brickrockler/surfclock/FINAL_PRINT_FILES/PURE_BLENDER_CYCLES_LOOKBOOK/08_colorway_02_panda_monochrome.jpg

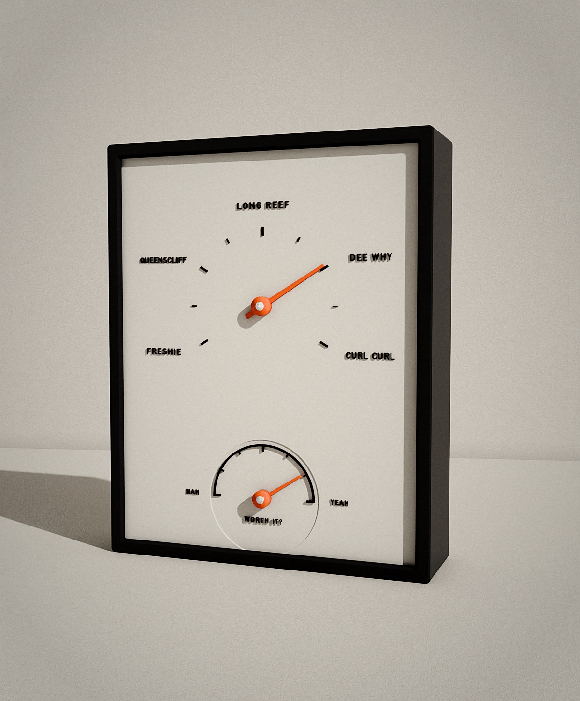
FINAL_PRINT_FILES/PURE_BLENDER_CYCLES_LOOKBOOK/08_colorway_02_panda_monochrome.jpg
