brickrockler/surfclock/HANDOFF.md

# Surf Clock Project Context (Auto-Loaded by Local Antigravity / Jetski IDE)

You are picking up the active industrial design, 3D printing, CAD, and firmware engineering session for `jcolley`'s **Surf Clock (001 Dieter Rams / Braun / Teenage Engineering V5 Click-Lock Edition)** in `/Users/jcolley/surf_clock`.

Read `README_ANTIGRAVITY_HANDOFF.md`, `V5_PERFECT_CLICKLOCK_PRINT_KIT/README_EXACT_PRINT_SETTINGS.md`, and `HANDOFF.md` immediately before responding to the user.

## Critical Execution Rules (Always On)
1. **Never Trigger IDE "Accept/Reject File" Banners**: Never use `write_to_file` or `replace_file_content`. Always create and modify files directly via `run_command` (`python3`, `cat << 'EOF'`, Blender CLI).
2. **Zero Confirmation Questions**: Execute all CAD, slicer, firmware, and script updates autonomously end-to-end.

## Current State & V5 Click-Lock Print Kit (`/Users/jcolley/surf_clock/V5_PERFECT_CLICKLOCK_PRINT_KIT/`)
All V5 STL files are 100% watertight (`non_manifold = 0`) and synced to `/Users/jcolley/surf_clock/FINAL_PRINT_FILES/`:
1. **`1_Outer_Frame_ClickLock_PrusaMK4.stl`** (`230.0 × 184.0 × 52.0 mm`, `166.9 cm³`) — Already printed by user with Fuzzy Skin (`0.10 / 0.30 mm`). Clean bezel corners (no circular corner nubs) + self-supporting `28°–31°` click-lock ledges (`0` overhang warnings). Optional slim version: `1b_OPTIONAL_Outer_Frame_SLIM_36mm_FastPrint_PrusaMK4.stl` (`36.0 mm` deep).
2. **`2a_Dial_Face_NORTHERN_BEACHES_Queensie_M600_at_Z2.6mm_PrusaMK4.stl`**, **`2b_Dial_Face_SYDNEY_ICONS_Bondi_Bronte_M600_at_Z2.6mm_PrusaMK4.stl`**, **`2c_Dial_Face_EASTERN_SUBURBS_Bondi_Coogee_M600_at_Z2.6mm_PrusaMK4.stl`** (`221.5 × 175.5 × 3.20 mm`) — Pure sharp rectangular dial plates (ZERO corner notches, ZERO boolean corner box artifacts, ZERO duplicate-triangle vulnerabilities). Slice at `0.20mm` with `M600` filament swap from Matte White to Matte Black at **`Z = 2.60 mm` (Layer 14)**.
3. **`NEW3_Motor_Mount_Plate_ClickLock_Audited_PrusaMK4.stl`** (also `FINAL_PRINT_FILES/3_Motor_Mount_Plate_ORANGE_or_WHITE_PrusaMK4.stl`, `222.4 × 176.4 × 12.6 mm`) — Features the sleek low-profile V3 ESP32 cradle (`Z = 9.50 mm` PCB shelf, `Z = 11.20 mm` side walls, `45°` snap clips) shifted UP `+41.0 mm` (`X = +2.0..+59.5 mm, Y = -51.0 mm`) for `51.8 mm` of USB-C plug clearance; and **Layers 1–3 (`Z = 0.00–0.60 mm`) are a 100% continuous unbroken flat sheet** (`38,491 mm²` bed contact area; all pin pockets and perimeter flex slots start at `Z = 0.60 mm` / Layer 4).
4. **`4a_Back_Cover_PURE_FLAT_TRANSLUCENT_HiddenClips_PrusaMK4.stl`**, **`4b_Back_Cover_BRAUN_LOUVERED_HiddenClips_PrusaMK4.stl`**, and **`4c_Back_Cover_FAST_1HR_CLEAR_WINDOW_PrusaMK4.stl`** (`222.0 × 176.0 × 7.5 mm`) — `4c` features a `3.0 mm` structural perimeter rim with a `1.0 mm` (4-layer) recessed optical center window that prints in `~55 minutes` with 3× clearer transparency.
5. **`5_Pointer_Hands_Skinny_Capped_PrusaMINI.stl`** — Skinny extended Braun pointer hands with built-in `Ø6.80 mm` shaft extender stems, `28BYJ-48` keyed D-bores, and solid capped tops.
6. **All CAD Generator Scripts:** Permanently saved in `/Users/jcolley/surf_clock/V5_PERFECT_CLICKLOCK_PRINT_KIT/scripts/`.
