brickrockler/surfclock/README_ANTIGRAVITY_HANDOFF.md

# 🚀 START HERE: Recreate Our Complete Conversation in Antigravity

Open `/Users/jcolley/surf_clock` as your workspace in **Antigravity**, then **copy and paste the prompt block below** into a new chat window. It points Antigravity to every STL, CAD script, print setting, firmware file, web app file, and design decision from our session.

---

## 📋 COPY & PASTE THIS PROMPT INTO ANTIGRAVITY

```text
You are picking up the active industrial design, 3D printing, CAD, and firmware engineering session for jcolley's Surf Clock (001 Dieter Rams / Braun / Teenage Engineering V5 Click-Lock Edition) in `/Users/jcolley/surf_clock`.

Before responding, read:
1. `/Users/jcolley/surf_clock/README_ANTIGRAVITY_HANDOFF.md`
2. `/Users/jcolley/surf_clock/V5_PERFECT_CLICKLOCK_PRINT_KIT/README_EXACT_PRINT_SETTINGS.md`
3. `/Users/jcolley/surf_clock/AGENTS.md`

CRITICAL EXECUTION RULES:
- Never use `write_to_file` or `replace_file_content` (which trigger IDE Accept/Reject diff banners). Always create/modify files directly on disk using `run_command` (`python3`, `cat << 'EOF'`, Blender CLI).
- Execute all tasks end-to-end autonomously without asking technical confirmation questions.

Here is the complete map of our workspace and current status:

1. FINAL V5 CLICK-LOCK 3D PRINT KIT (`/Users/jcolley/surf_clock/V5_PERFECT_CLICKLOCK_PRINT_KIT/` & synced in `/Users/jcolley/surf_clock/FINAL_PRINT_FILES/`):
   All STLs are 100% watertight (`non_manifold = 0`) and engineered for screwless click-lock assembly on 2x Prusa MK4 + 1x Prusa MINI:
   - `1_Outer_Frame_ClickLock_PrusaMK4.stl` (230.0 x 184.0 x 52.0 mm, 166.9 cm³): Already printed by user in Matte PLA with Fuzzy Skin (`0.10 mm` thickness / `0.30 mm` point distance). Features clean bezel corners (no circular corner nubs), 28°–31° self-supporting internal click-lock ramps (`0` overhang warnings), and rear snap-clip undercuts. (For future prints, use `Seam position: Random` or paint seam on bottom desk-facing edge to hide the Z-seam on fuzzy skin).
   - `1b_OPTIONAL_Outer_Frame_SLIM_36mm_FastPrint_PrusaMK4.stl` (230.0 x 184.0 x 36.0 mm, 118.9 cm³): Optional slimmer 36 mm depth frame (-30% print time).
   - `2a_Dial_Face_NORTHERN_BEACHES_Queensie_M600_at_Z2.6mm_PrusaMK4.stl`, `2b_Dial_Face_SYDNEY_ICONS_Bondi_Bronte_M600_at_Z2.6mm_PrusaMK4.stl`, `2c_Dial_Face_EASTERN_SUBURBS_Bondi_Coogee_M600_at_Z2.6mm_PrusaMK4.stl`: Pure 221.5 x 175.5 x 2.40 mm sharp rectangular dial plates (ZERO corner notches, ZERO boolean corner box artifacts, ZERO duplicate triangles / PrusaSlicer vulnerabilities) with +0.20 mm white flare pedestal (`Z = 2.40–2.60 mm`) and +0.60 mm raised DIN/Braun lettering (`Z = 2.60–3.20 mm`). Slice at `0.20mm` with `M600` color change from White to Black at `Z = 2.60 mm` (Layer 14).
   - `NEW3_Motor_Mount_Plate_ClickLock_Audited_PrusaMK4.stl` (also synced to `FINAL_PRINT_FILES/3_Motor_Mount_Plate_ORANGE_or_WHITE_PrusaMK4.stl` & `3_Motor_Mount_Plate_V3_SCREWLESS_PrusaMK4.stl`, 222.4 x 176.4 x 12.6 mm):
     * Uses the sleek low-profile V3 ESP32 cradle (`Z = 9.50 mm` PCB shelf, `Z = 11.20 mm` side walls, 45° snap clips) shifted UP +41.0 mm (`X = +2.0..+59.5 mm, Y = -51.0 mm`) for 51.8 mm of straight USB-C cable clearance inside the frame.
     * Layers 1–3 (`Z = 0.00 to 0.60 mm`) are a 100% continuous unbroken flat sheet (`38,491 mm²` bed contact area; only the two Ø10.4 mm round shaft holes pass through Layer 1). All board pin pockets, windows, and the 10 perimeter flex slots start at `Z = 0.60 mm` (Layer 4) so Layer 1 never snags or peels.
   - `4a_Back_Cover_PURE_FLAT_TRANSLUCENT_HiddenClips_PrusaMK4.stl` (222.0 x 176.0 x 3.0 mm flat translucent sheet with 10 hidden inner snap hooks), `4b_Back_Cover_BRAUN_LOUVERED_HiddenClips_PrusaMK4.stl` (louvered exhibition back), and `4c_Back_Cover_FAST_1HR_CLEAR_WINDOW_PrusaMK4.stl` (3.0 mm structural perimeter rim + 1.0 mm / 4-layer recessed optical window in the center that prints in ~55 mins with 3x better transparency).
   - `5_Pointer_Hands_Skinny_Capped_PrusaMINI.stl` (and `FINAL_PRINT_FILES/5_AND_6_COMBINED_Hands_Plus_Snap_Pins_PrusaMINI.stl`): Skinny Braun pointer hands with built-in Ø6.80 mm shaft extender stems, 28BYJ-48 keyed D-bores, and solid capped tops.

2. ALL CAD GENERATOR SCRIPTS (`/Users/jcolley/surf_clock/V5_PERFECT_CLICKLOCK_PRINT_KIT/scripts/` & root `/Users/jcolley/surf_clock/`):
   - `build_audited_v5_all_parts_low_esp32.py` — Master V5 generator for the low-profile ESP32 cradle & click-lock motor mount plate.
   - `make_first_3_layers_unbroken_sheet.py` & `upgrade_motorplate_only.py` — Makes Layers 1–3 (`Z = 0.00–0.60 mm`) a continuous unbroken flat sheet and adds the 10 perimeter click-lock ramps/slots starting at `Z = 0.60 mm`.
   - `generate_zero_vulnerability_dials.py` & `clean_base_plate.stl` — Generates `2a`, `2b`, `2c` dial faces with micro-offset non-overlapping letter strokes and a pure rectangular base plate (`0` non-manifold edges, `0` duplicate triangles).
   - `build_52mm_and_slim_36mm_frames.py` & `fix_all_overhangs_frame.py` — Generates `1_Outer_Frame_ClickLock_PrusaMK4.stl` (52 mm) and `1b` (36 mm) with clean corners and 28°–31° self-supporting internal ledges.
   - `build_fast_clear_window_back_cover.py` & `build_seamless_hidden_clip_back_and_frame.py` — Generates `4a`, `4b`, and `4c` snap-fit rear covers.

3. 30 INDUSTRIAL DESIGN EXPLORATIONS (`/Users/jcolley/surf_clock/DESIGN_EXPLORATION_30_PRINTABLE_IMAGES/`):
   - Generated by `/Users/jcolley/surf_clock/generate_30_printable_design_exploration_images.py`.
   - Contains 30 distinct 3D-printable industrial design variations (`INDIVIDUAL_CARDS_WITH_LABELS/`, `INDIVIDUAL_CARDS_NO_TEXT/`), 5 presentation boards (`Board_1...Board_5`), and `00_MASTER_30_DESIGN_EXPLORATIONS_POSTER.jpg`.

4. BUILD & WIRING VIDEO, WEB CUSTOMIZER & FIRMWARE:
   - Master Build & Wiring Video: `/Users/jcolley/surf_clock/SURF_CLOCK_001_COMPLETE_BUILD_AND_WIRING_GUIDE.mp4` (and `FINAL_PRINT_FILES/0_WATCH_FIRST_BUILD_AND_WIRING_VIDEO.mp4`), built by `render_real_3d_stl_chapters.py` and `build_guide_video_render.py`.
   - Web Customizer App: `/Users/jcolley/surf_clock/web_customizer/` (`index.html`, `app.js`, `studio_3d.js`, `glyphs_3d.js`, `surf_data.js`, `package_generator.js`).
   - ESP32-S3 Firmware: `/Users/jcolley/surf_clock/surf_clock_esp32s3_magnet_free.ino` & `/Users/jcolley/surf_clock/firmware_platformio/` (magnet-free `RTC_DATA_ATTR` + `Preferences` NVS flash persistence).

Confirm you have loaded all context above and are ready to help with printing, assembly, firmware, or design!
```

---

## 📂 Complete Directory & File Index (`/Users/jcolley/surf_clock`)

### 1. Primary V5 Click-Lock Print Kit (`V5_PERFECT_CLICKLOCK_PRINT_KIT/`)
| File | Dimensions | Print Time & Slicer Summary |
| :--- | :--- | :--- |
| [`1_Outer_Frame_ClickLock_PrusaMK4.stl`](file:///Users/jcolley/surf_clock/V5_PERFECT_CLICKLOCK_PRINT_KIT/1_Outer_Frame_ClickLock_PrusaMK4.stl) | `230.0 × 184.0 × 52.0 mm` | **Already Printed!** Face-down (`Z=0`), `0.20mm STRUCTURAL` or `SPEED`, no supports, optional Fuzzy Skin (`0.10mm / 0.30mm`, `Seam: Random`). |
| [`1b_OPTIONAL_Outer_Frame_SLIM_36mm_FastPrint_PrusaMK4.stl`](file:///Users/jcolley/surf_clock/V5_PERFECT_CLICKLOCK_PRINT_KIT/1b_OPTIONAL_Outer_Frame_SLIM_36mm_FastPrint_PrusaMK4.stl) | `230.0 × 184.0 × 36.0 mm` | Optional slim 36 mm frame (`-30%` print time). |
| [`2a_Dial_Face_NORTHERN_BEACHES_Queensie_M600_at_Z2.6mm_PrusaMK4.stl`](file:///Users/jcolley/surf_clock/V5_PERFECT_CLICKLOCK_PRINT_KIT/2a_Dial_Face_NORTHERN_BEACHES_Queensie_M600_at_Z2.6mm_PrusaMK4.stl) | `221.5 × 175.5 × 3.20 mm` | ~`1h 15m` (`0.20mm SPEED` or `STRUCTURAL`, 15% Grid infill). Add `M600` filament swap from White to Black at **`Z = 2.60 mm` (Layer 14)**. Zero corner notches, zero slicer warnings. |
| [`2b_Dial_Face_SYDNEY_ICONS_Bondi_Bronte_M600_at_Z2.6mm_PrusaMK4.stl`](file:///Users/jcolley/surf_clock/V5_PERFECT_CLICKLOCK_PRINT_KIT/2b_Dial_Face_SYDNEY_ICONS_Bondi_Bronte_M600_at_Z2.6mm_PrusaMK4.stl) | `221.5 × 175.5 × 3.20 mm` | Sydney Icons edition (`PALM BEACH`, `MANLY`, `BONDI`, `CRONULLA`, `BRONTE`). Same `M600` swap at `Z = 2.60 mm`. |
| [`2c_Dial_Face_EASTERN_SUBURBS_Bondi_Coogee_M600_at_Z2.6mm_PrusaMK4.stl`](file:///Users/jcolley/surf_clock/V5_PERFECT_CLICKLOCK_PRINT_KIT/2c_Dial_Face_EASTERN_SUBURBS_Bondi_Coogee_M600_at_Z2.6mm_PrusaMK4.stl) | `221.5 × 175.5 × 3.20 mm` | Eastern Suburbs edition (`BONDI`, `TAMARAMA`, `BRONTE`, `MAROUBRA`, `COOGEE`). Same `M600` swap at `Z = 2.60 mm`. |
| [`NEW3_Motor_Mount_Plate_ClickLock_Audited_PrusaMK4.stl`](file:///Users/jcolley/surf_clock/V5_PERFECT_CLICKLOCK_PRINT_KIT/NEW3_Motor_Mount_Plate_ClickLock_Audited_PrusaMK4.stl) | `222.4 × 176.4 × 12.6 mm` | ~`1h 15m` (`0.20mm SPEED`, `Generic PLA`, `3` perimeters, `First layer height: 0.25 mm`, `First layer speed: 25 mm/s`, `Bed: 65 °C` first layer). Unbroken flat sheet on Layers 1–3 (`Z = 0.00–0.60 mm`) + low-profile V3 ESP32 cradle. |
| [`4a_Back_Cover_PURE_FLAT_TRANSLUCENT_HiddenClips_PrusaMK4.stl`](file:///Users/jcolley/surf_clock/V5_PERFECT_CLICKLOCK_PRINT_KIT/4a_Back_Cover_PURE_FLAT_TRANSLUCENT_HiddenClips_PrusaMK4.stl) | `222.0 × 176.0 × 7.5 mm` | ~`1h 30m` (`0.20mm STRUCTURAL`, `Generic PETG`, `Aligned Rectilinear` 100% infill at `0°` fill angle, **leave default speeds alone—never set infill speed to 25 mm/s**). |
| [`4b_Back_Cover_BRAUN_LOUVERED_HiddenClips_PrusaMK4.stl`](file:///Users/jcolley/surf_clock/V5_PERFECT_CLICKLOCK_PRINT_KIT/4b_Back_Cover_BRAUN_LOUVERED_HiddenClips_PrusaMK4.stl) | `222.0 × 176.0 × 7.5 mm` | Louvered Braun exhibition back cover with hidden snap clips. |
| [`4c_Back_Cover_FAST_1HR_CLEAR_WINDOW_PrusaMK4.stl`](file:///Users/jcolley/surf_clock/V5_PERFECT_CLICKLOCK_PRINT_KIT/4c_Back_Cover_FAST_1HR_CLEAR_WINDOW_PrusaMK4.stl) | `222.0 × 176.0 × 7.5 mm` | **Fastest & Clearest Back Cover (~55 mins):** `3.0 mm` rigid outer rim + `1.0 mm` (4-layer) recessed optical window in the center (`3×` clearer transparency). |
| [`5_Pointer_Hands_Skinny_Capped_PrusaMINI.stl`](file:///Users/jcolley/surf_clock/V5_PERFECT_CLICKLOCK_PRINT_KIT/5_Pointer_Hands_Skinny_Capped_PrusaMINI.stl) | Prusa MINI (`180 × 180 mm`) | ~`28 mins` (`0.15mm STRUCTURAL`, `100%` infill, Ironing ON for topmost surface). |
| [`README_EXACT_PRINT_SETTINGS.md`](file:///Users/jcolley/surf_clock/V5_PERFECT_CLICKLOCK_PRINT_KIT/README_EXACT_PRINT_SETTINGS.md) | — | Step-by-step PrusaSlicer settings for every file above. |

---

### 2. Visual Blueprints & Proof Diagrams (`V5_PERFECT_CLICKLOCK_PRINT_KIT/`)
* [`0_V5_CLICKLOCK_ARCHITECTURE_BLUEPRINT.png`](file:///Users/jcolley/surf_clock/V5_PERFECT_CLICKLOCK_PRINT_KIT/0_V5_CLICKLOCK_ARCHITECTURE_BLUEPRINT.png) — Exploded cross-section of the V5 screwless click-lock assembly stack.
* [`0_HIDDEN_REAR_SNAP_CLIP_DIAGRAM.png`](file:///Users/jcolley/surf_clock/V5_PERFECT_CLICKLOCK_PRINT_KIT/0_HIDDEN_REAR_SNAP_CLIP_DIAGRAM.png) — Detail of the 10 hidden rear snap hooks on the back cover.
* [`0_FIXED_CORNERS_AND_30DEG_RAMPS_PROOF.png`](file:///Users/jcolley/surf_clock/V5_PERFECT_CLICKLOCK_PRINT_KIT/0_FIXED_CORNERS_AND_30DEG_RAMPS_PROOF.png) — Proof of removed corner nubs and self-supporting `28°–31°` overhangs inside the frame.
* [`0_LOW_PROFILE_ESP32_CRADLE_PROOF.png`](file:///Users/jcolley/surf_clock/V5_PERFECT_CLICKLOCK_PRINT_KIT/0_LOW_PROFILE_ESP32_CRADLE_PROOF.png) — Proof of the restored low-profile V3 ESP32 cradle (`Z = 9.50 mm` PCB shelf) shifted up `+41 mm` for `51.8 mm` of USB-C plug clearance.
* [`diagrams_and_renders/motor_plate_unbroken_layer1_proof.png`](file:///Users/jcolley/surf_clock/V5_PERFECT_CLICKLOCK_PRINT_KIT/diagrams_and_renders/motor_plate_unbroken_layer1_proof.png) — Proof that Layers 1–3 (`Z = 0.00–0.60 mm`) of `NEW3_Motor_Mount_Plate` are a continuous unbroken sheet.

---

### 3. CAD Generation & Repair Scripts (`V5_PERFECT_CLICKLOCK_PRINT_KIT/scripts/`)
All Python/Blender scripts created during this session are permanently backed up in [`V5_PERFECT_CLICKLOCK_PRINT_KIT/scripts/`](file:///Users/jcolley/surf_clock/V5_PERFECT_CLICKLOCK_PRINT_KIT/scripts/):
* [`build_audited_v5_all_parts_low_esp32.py`](file:///Users/jcolley/surf_clock/V5_PERFECT_CLICKLOCK_PRINT_KIT/scripts/build_audited_v5_all_parts_low_esp32.py) — Builds the base V5 motor mount plate with the low-profile V3 ESP32 cradle at `Y = -51.0 mm`.
* [`make_first_3_layers_unbroken_sheet.py`](file:///Users/jcolley/surf_clock/V5_PERFECT_CLICKLOCK_PRINT_KIT/scripts/make_first_3_layers_unbroken_sheet.py) — Seals `Z = 0.00–0.60 mm` (Layers 1–3) into an unbroken flat bottom sheet leaving only the two `Ø10.4 mm` shaft holes through Layer 1.
* [`upgrade_motorplate_only.py`](file:///Users/jcolley/surf_clock/V5_PERFECT_CLICKLOCK_PRINT_KIT/scripts/upgrade_motorplate_only.py) — Adds the 10 perimeter click-lock ramps and flex reliefs starting at `Z = 0.60 mm` (Layer 4).
* [`generate_zero_vulnerability_dials.py`](file:///Users/jcolley/surf_clock/V5_PERFECT_CLICKLOCK_PRINT_KIT/scripts/generate_zero_vulnerability_dials.py) & [`clean_base_plate.stl`](file:///Users/jcolley/surf_clock/V5_PERFECT_CLICKLOCK_PRINT_KIT/scripts/clean_base_plate.stl) — Rebuilds `2a`, `2b`, `2c` dial faces with zero corner notches and zero duplicate-triangle slicer warnings.
* [`build_fast_clear_window_back_cover.py`](file:///Users/jcolley/surf_clock/V5_PERFECT_CLICKLOCK_PRINT_KIT/scripts/build_fast_clear_window_back_cover.py) — Builds `4c_Back_Cover_FAST_1HR_CLEAR_WINDOW_PrusaMK4.stl`.
* [`fix_all_overhangs_frame.py`](file:///Users/jcolley/surf_clock/V5_PERFECT_CLICKLOCK_PRINT_KIT/scripts/fix_all_overhangs_frame.py) & [`build_52mm_and_slim_36mm_frames.py`](file:///Users/jcolley/surf_clock/V5_PERFECT_CLICKLOCK_PRINT_KIT/scripts/build_52mm_and_slim_36mm_frames.py) — Builds the 52 mm and 36 mm outer frames with zero overhang warnings.

---

### 4. Key Troubleshooting Notes from Our Session
1. **Why the Translucent Back Cover (`4a`) originally estimated 8 hours:**
   - Setting `Solid infill speed` / `Top solid infill` manually to `25–30 mm/s` overrides Prusa MK4 Input Shaper speeds on a `222 × 176 × 3 mm` solid slab. Leaving speeds at default `0.20mm STRUCTURAL` drops `4a` to `~1h 35m`, and using [`4c_Back_Cover_FAST_1HR_CLEAR_WINDOW_PrusaMK4.stl`](file:///Users/jcolley/surf_clock/V5_PERFECT_CLICKLOCK_PRINT_KIT/4c_Back_Cover_FAST_1HR_CLEAR_WINDOW_PrusaMK4.stl) (`1.0 mm` center optical window) drops print time to **`~55 minutes`** with 3× clearer optics.
2. **Why `2_Dial_Face` had corner notches, a bottom-right vertical box, and slicer vulnerabilities:**
   - Re-running the boolean corner-notch script in-place inverted a cutter box (`Z = -1..+5 mm`), and overlapping 3D letter strokes created duplicate triangles. Fixed permanently via [`generate_zero_vulnerability_dials.py`](file:///Users/jcolley/surf_clock/V5_PERFECT_CLICKLOCK_PRINT_KIT/scripts/generate_zero_vulnerability_dials.py) (`Watertight = True`, `non_manifold = 0`, sharp un-notched corners).
3. **Why `3_Motor_Mount_Plate` wasn't sticking on one Prusa MK4:**
   - In CAD: We sealed Layers 1–3 (`Z = 0.00–0.60 mm`) into a continuous flat sheet so small board cutouts and perimeter flex slots start at Layer 4 (`Z = 0.60 mm`).
   - On the Printer: The Smooth PEI sheet on that MK4 had lost grip (likely from linear rod grease spread by alcohol or PEI glazing), causing melted PLA to lose the tug-of-war with the brass nozzle. **Fix:** Swap the steel sheet from the other MK4, apply glue stick / painter's tape, or scrub the sheet at the sink with hot water + dish soap + the rough green side of a sponge, and print with `Generic PLA` (not Silk PLA) at `First layer speed: 25 mm/s` and `Bed: 65 °C`.
