brickrockler/surfclock/STUDIO_4K_CINEMA_PIPELINE/README_4K_CINEMA_COLLECTION.md

# 001 Surf Clock — V8 Frontier 100-Shot 4K Photography & 4K 60fps Silent Cinema Collection

All **100 Native 4K (`3840×2160`) Studio & Film Stills** and **100 Corresponding 8-Second Silent 4K 60fps (`3840×2160`, `-an`) Cinema Clips** (`V8_001` through `V8_100`) are complete, adversarially audited across 20 overnight iterations, and temporally verified across 5 timepoints (`t=0.0s`, `t=1.5s`, `t=4.2s`, `t=6.2s`, and `t=7.4s`).

## Quick Links
- **Interactive Browser Lookbook (All 100 Stills + 100 Videos Side-by-Side)**: [`00_V8_FRONTIER_100_LOOKBOOK.html`](./00_V8_FRONTIER_100_LOOKBOOK.html)
- **100-Cut Master Selects Reel (Silent 4K 60fps, 3.53 GB)**: [`00_MASTER_SHOWREELS/00_SURF_CLOCK_V8_FRONTIER_MASTER_SELECTS_REEL_4K60_SILENT.mp4`](./00_MASTER_SHOWREELS/00_SURF_CLOCK_V8_FRONTIER_MASTER_SELECTS_REEL_4K60_SILENT.mp4)
- **100 Native 4K Stills (`3840×2160`)**: [`01_4K_STUDIO_KEYFRAMES_AND_STILLS/`](./01_4K_STUDIO_KEYFRAMES_AND_STILLS/)
- **100 Individual Silent 4K 60fps Clips (`8.0s`, `-an`)**: [`02_INDIVIDUAL_4K_CLIPS_16x9/`](./02_INDIVIDUAL_4K_CLIPS_16x9/)

## 5-Point Temporal 10×10 Contact Sheets (`04_CONTACT_SHEETS_AND_AUDIT/`)
- **`t=0.0s` (All 100 4K Stills)**: [`04_CONTACT_SHEETS_AND_AUDIT/00_V8_ALL_100_4K_STILLS_CONTACT_SHEET.jpg`](./04_CONTACT_SHEETS_AND_AUDIT/00_V8_ALL_100_4K_STILLS_CONTACT_SHEET.jpg)
- **`t=1.5s` (All 100 Video Early Frames)**: [`04_CONTACT_SHEETS_AND_AUDIT/00_V8_ALL_100_VIDEO_EARLYFRAMES_t1.5s_CONTACT_SHEET.jpg`](./04_CONTACT_SHEETS_AND_AUDIT/00_V8_ALL_100_VIDEO_EARLYFRAMES_t1.5s_CONTACT_SHEET.jpg)
- **`t=4.2s` (All 100 Video Mid Frames)**: [`04_CONTACT_SHEETS_AND_AUDIT/00_V8_ALL_100_VIDEO_MIDFRAMES_t4.2s_CONTACT_SHEET.jpg`](./04_CONTACT_SHEETS_AND_AUDIT/00_V8_ALL_100_VIDEO_MIDFRAMES_t4.2s_CONTACT_SHEET.jpg)
- **`t=6.2s` (All 100 Video Late Frames)**: [`04_CONTACT_SHEETS_AND_AUDIT/00_V8_ALL_100_VIDEO_LATEFRAMES_t6.2s_CONTACT_SHEET.jpg`](./04_CONTACT_SHEETS_AND_AUDIT/00_V8_ALL_100_VIDEO_LATEFRAMES_t6.2s_CONTACT_SHEET.jpg)
- **`t=7.4s` (All 100 Video End Frames)**: [`04_CONTACT_SHEETS_AND_AUDIT/00_V8_ALL_100_VIDEO_ENDFRAMES_t7.4s_CONTACT_SHEET.jpg`](./04_CONTACT_SHEETS_AND_AUDIT/00_V8_ALL_100_VIDEO_ENDFRAMES_t7.4s_CONTACT_SHEET.jpg)

## 6 Curated Aesthetic World Films (`00_MASTER_SHOWREELS/`)
1. **`FILM_01_CAUSTIC_BLUE_CYCLORAMA_BRAUN_MONOGRAPH_4K60.mp4`** (`V8_001` – `V8_018`, 18 shots, 538.0 MB) — Deep cobalt & Yves Klein studio cycloramas with refracted underwater ocean caustics, volcanic basalt, and travertine plinths.
2. **`FILM_02_1974_DOMUS_AND_SONY_ANALOG_STUDIO_4K60.mp4`** (`V8_019` – `V8_036`, 18 shots, 542.7 MB) — 1974 Milan *Domus* editorial sets, brutalist concrete, smoked acrylic, brushed aluminum, and warm tungsten studio fresnels.
3. **`FILM_03_ZERO_GRAVITY_POISED_SUSPENSION_4K60.mp4`** (`V8_037` – `V8_052`, 16 shots, 659.1 MB) — Poised zero-gravity architectural suspension studies, exploded V5 click-lock assemblies, and cantilevered balances.
4. **`FILM_04_100MM_MACRO_HOROLOGY_AND_TELEMETRY_4K60.mp4`** (`V8_053` – `V8_068`, 16 shots, 715.2 MB) — Laowa 24mm Probe & Hasselblad HC 120mm Macro extreme close-ups of the `10mm` recessed step-wall, `M600` raised matte-black typography, and single burnt-orange pointer collet.
5. **`FILM_05_ARCHITECTURAL_MARBLE_AND_ALABASTER_GALLERY_4K60.mp4`** (`V8_069` – `V8_084`, 16 shots, 432.2 MB) — Translucent Spanish honey alabaster, Verde Alpi marble, Roman travertine, and Peter Zumthor-inspired monolithic stone galleries.
6. **`FILM_06_1970S_ITALIAN_AND_AUSSIE_16MM_35MM_SURF_CINEMA_4K60.mp4`** (`V8_085` – `V8_100`, 16 shots, 616.9 MB) — Authentic 1970s 35mm Kodak 5254 & 16mm Ektachrome coastal surf cinema across Amalfi, Capri, Freshwater, Queenscliff, and Milan lofts.

## Enforced Horological & Industrial Design Lock
- **Strictly 1 Burnt-Orange Pointer Hand Per Dial**: One long hand on the upper beach dial (`FRESHIE`, `QUEENSIE`, `LONG REEF`, `DEE WHY`, `CURL CURL`) and one shorter hand on the lower `WORTH IT?` sub-dial (`NAH` / `YEAH`).
- **Strictly 9 Upper Radial Tick Marks**: Upper/side arc (`8:30` to `3:30`) only; bottom arc (`4:00` to `8:00`) is 100% blank smooth matte dial surface.
- **Zero Glass Cover & Sharp Monolith Geometry**: `230 × 184 × 52 mm` rectangular bezel with a `10 mm` deep recessed dial face.
- **Zero Cliché Lighting or Foreground Obstructions**: Zero Venetian blind shadows, zero metallic titanium, zero foreground obstructions crossing the dial face, and monotonic `lastFrame`-locked optical camera motion.
