brickrockler/surfclock/FINAL_PRINT_FILES/PHOTOGRAPHY_LOOKBOOK/raw_macro_electronics_detail.jpg

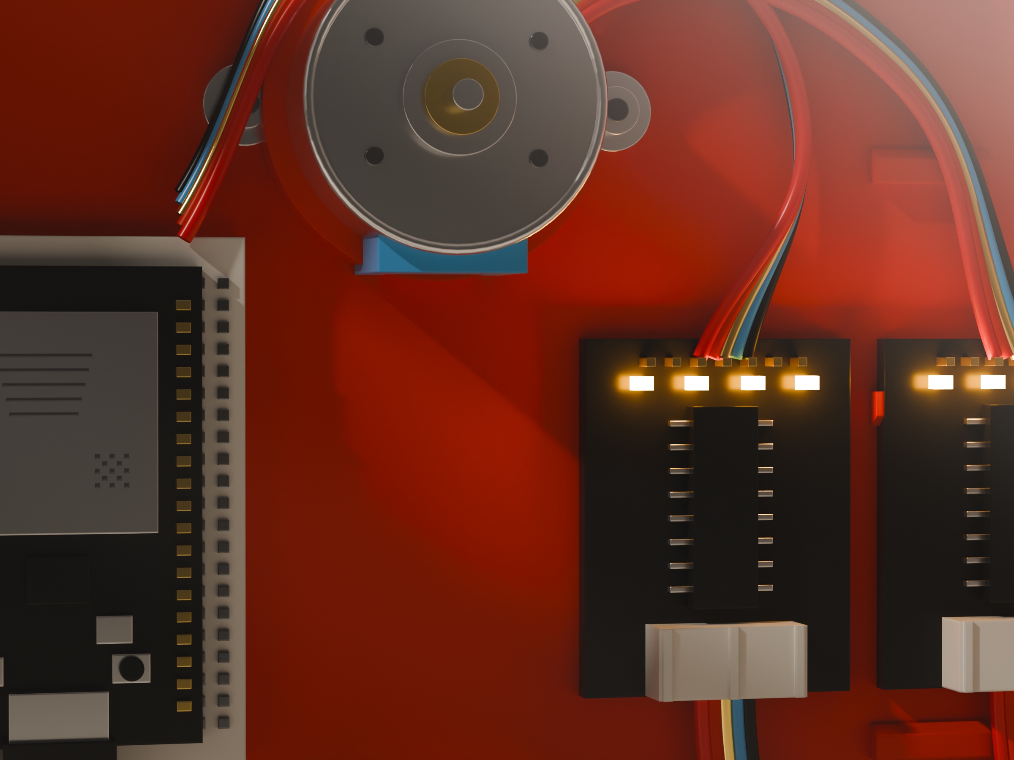
FINAL_PRINT_FILES/PHOTOGRAPHY_LOOKBOOK/raw_macro_electronics_detail.jpg
