brickrockler/surfclock/V5_PERFECT_CLICKLOCK_PRINT_KIT/0_V5_CLICKLOCK_ARCHITECTURE_BLUEPRINT.png

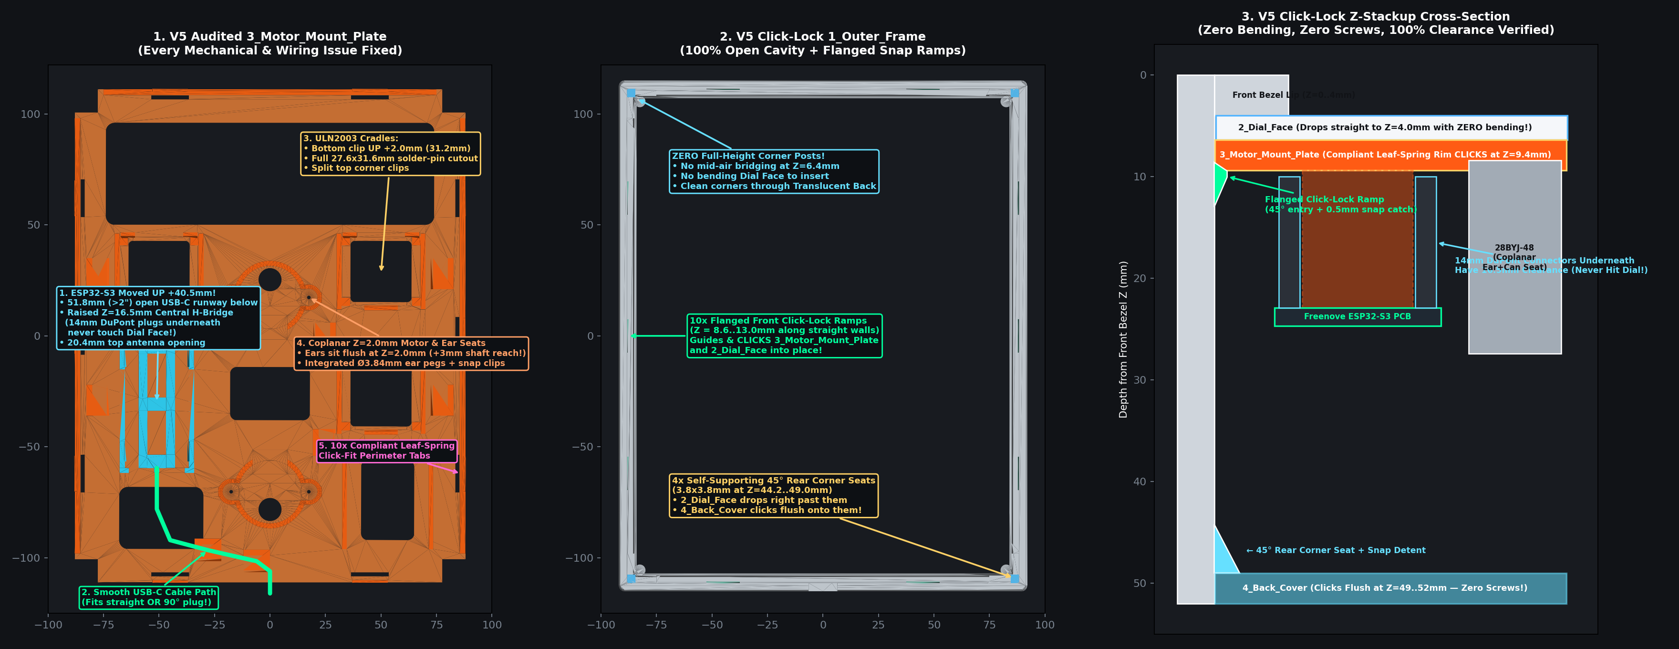
V5_PERFECT_CLICKLOCK_PRINT_KIT/0_V5_CLICKLOCK_ARCHITECTURE_BLUEPRINT.png
