brickrockler/surfclock/V5_PERFECT_CLICKLOCK_PRINT_KIT/diagrams_and_renders/motor_plate_v4_and_frame_architecture.png

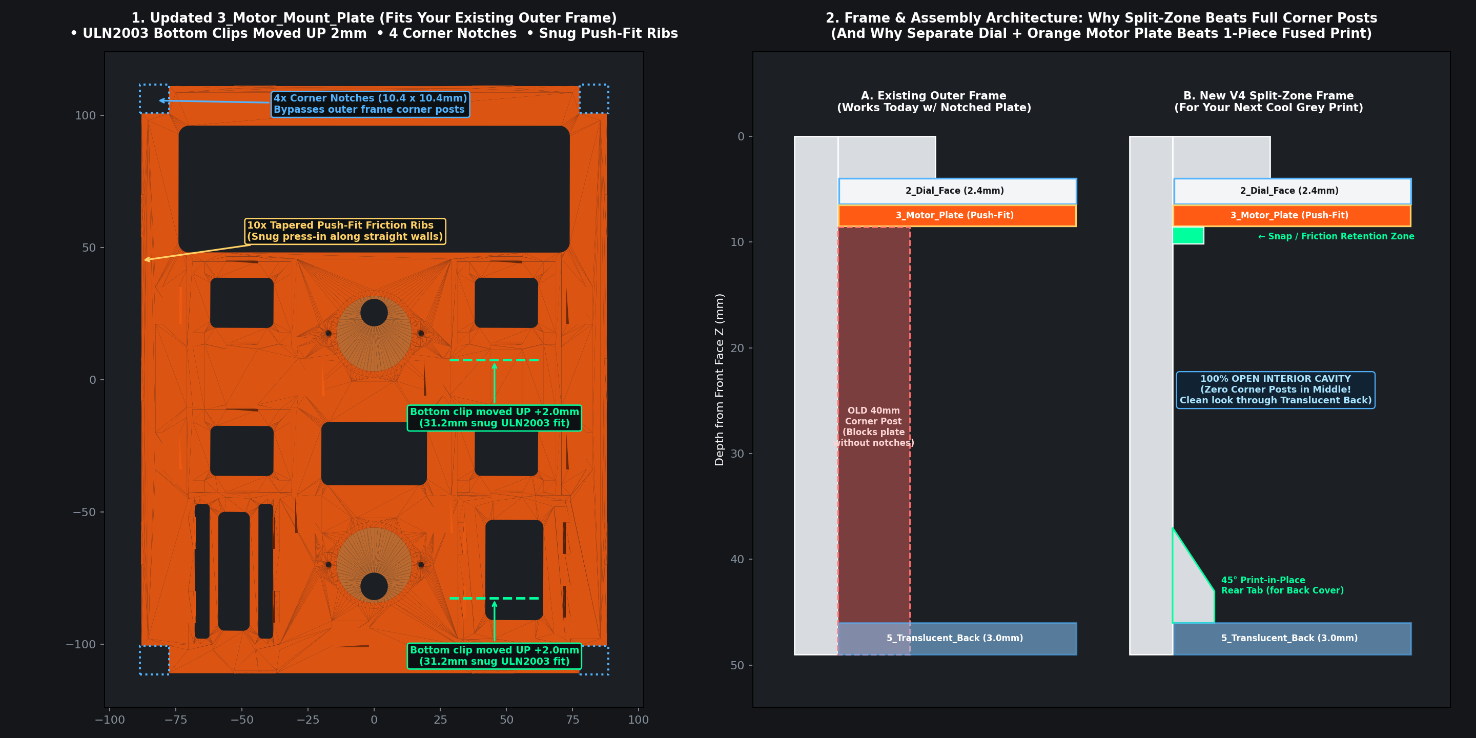
V5_PERFECT_CLICKLOCK_PRINT_KIT/diagrams_and_renders/motor_plate_v4_and_frame_architecture.png
