brickrockler/surfclock/5a_SinglePair_V3_Standard_2.2mm_SteppedBase_Hands_PrusaMINI.stl

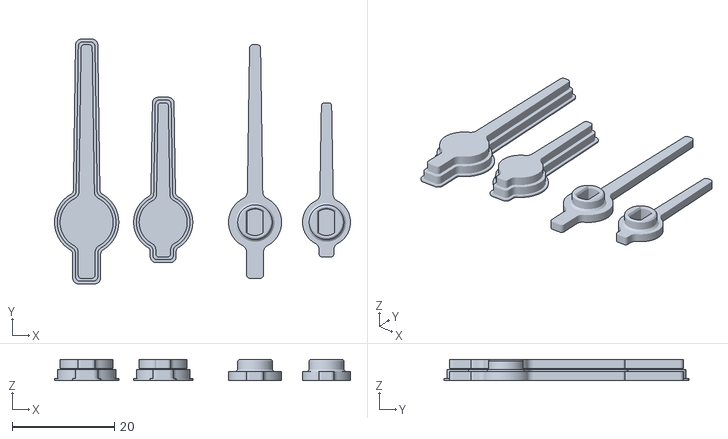
[picture p6: CAD file, 2026-10-15]
5a_SinglePair_V3_Standard_2.2mm_SteppedBase_Hands_PrusaMINI.stl
58.0 x 48.0 x 4.20
