brickrockler/surfclock/FINAL_PRINT_FILES/5_AND_6_COMBINED_Hands_NO_CRADLE_Plus_Snap_Pins_PrusaMINI.stl

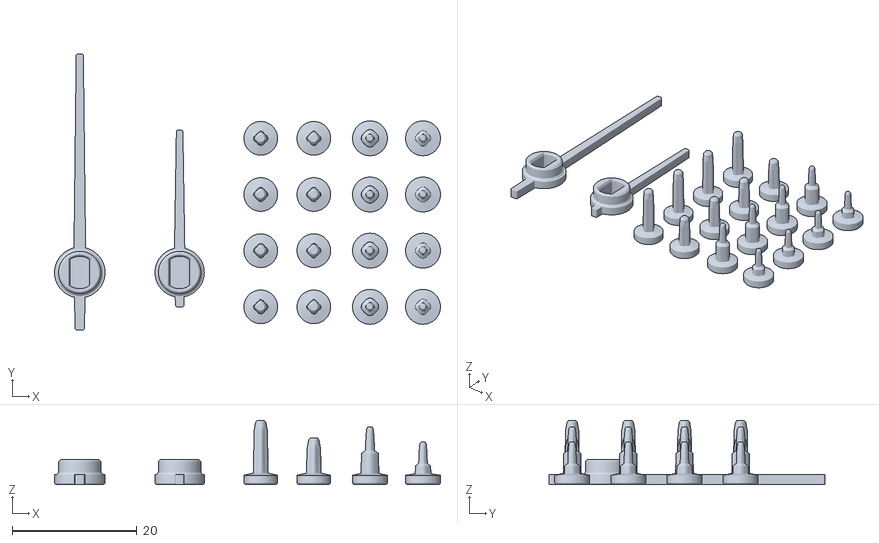
[picture p7: CAD file, 2026-10-15]
FINAL_PRINT_FILES/5_AND_6_COMBINED_Hands_NO_CRADLE_Plus_Snap_Pins_PrusaMINI.stl
61.8 x 44.2 x 10.3
