brickrockler/surfclock/V5_PERFECT_CLICKLOCK_PRINT_KIT/1b_OPTIONAL_Outer_Frame_SLIM_36mm_FastPrint_PrusaMK4.stl

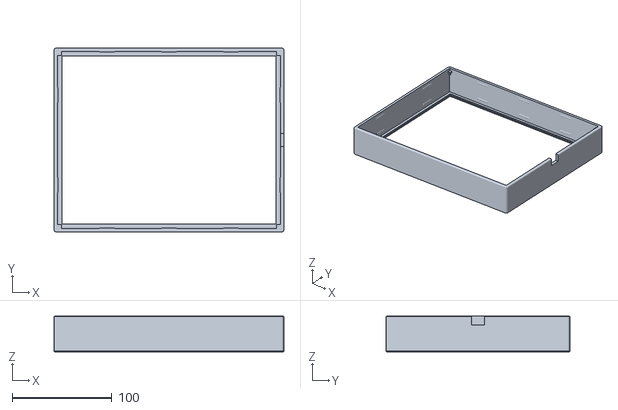
[picture p8: CAD file, 2026-10-15]
V5_PERFECT_CLICKLOCK_PRINT_KIT/1b_OPTIONAL_Outer_Frame_SLIM_36mm_FastPrint_PrusaMK4.stl
230.0 x 184.0 x 36.0
