brickrockler/surfclock/V5_PERFECT_CLICKLOCK_PRINT_KIT/scripts/hand_lower_centered.stl

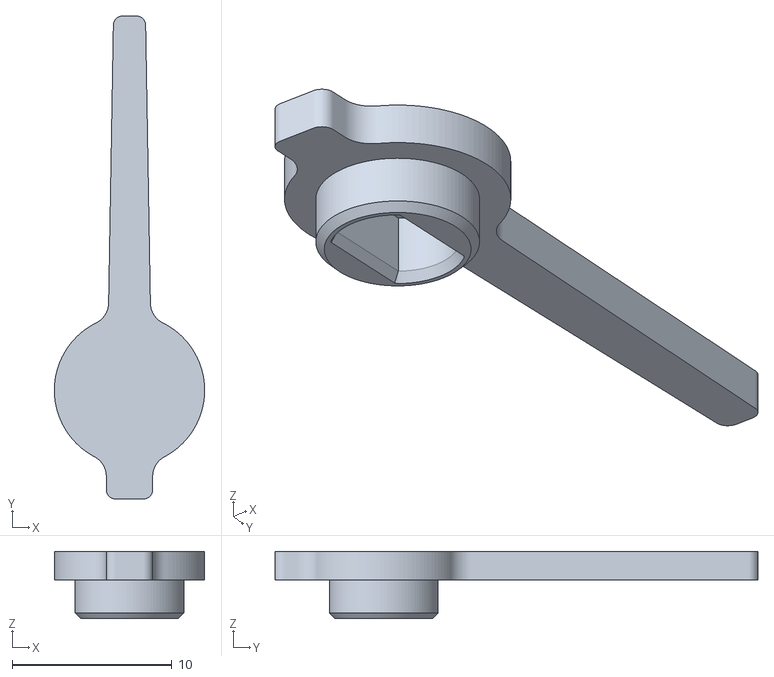
[picture p9: CAD file, 2026-10-15]
V5_PERFECT_CLICKLOCK_PRINT_KIT/scripts/hand_lower_centered.stl
9.40 x 30.2 x 4.20
