brickrockler/surfclock/2_Dial_Face_V2_REINFORCED_SOLID_PrusaMK4.stl

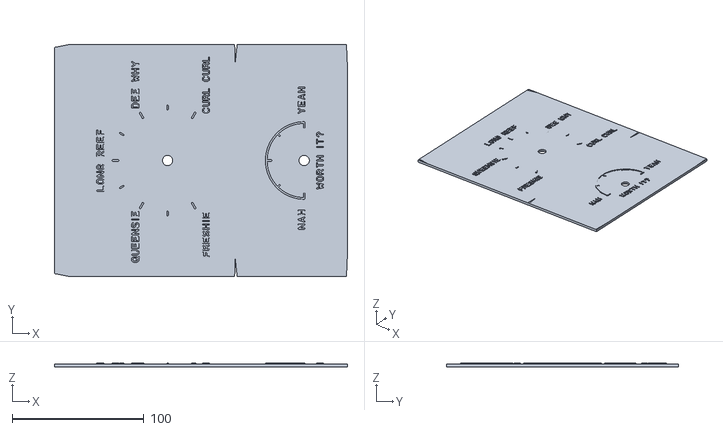
[picture p10: CAD file, 2026-10-15]
2_Dial_Face_V2_REINFORCED_SOLID_PrusaMK4.stl
222.0 x 176.0 x 3.16
