brickrockler/surfclock/FINAL_PRINT_FILES/2_Dial_Face_V3_QUEENSIE_Reinforced_PrusaMK4.stl

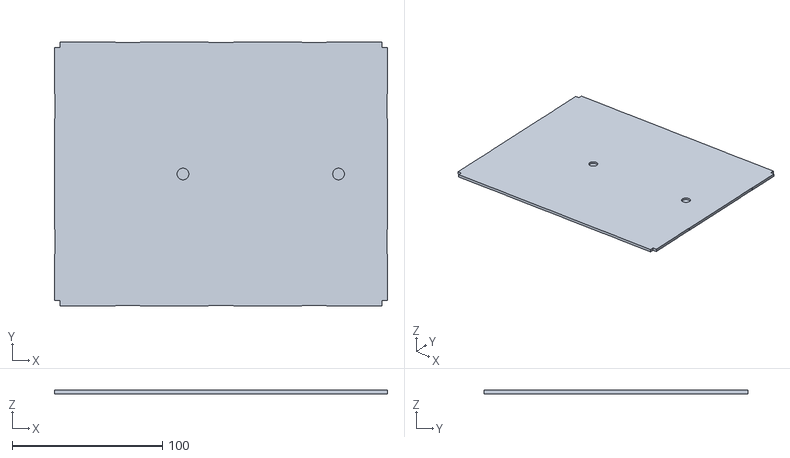
[picture p11: CAD file, 2026-10-15]
FINAL_PRINT_FILES/2_Dial_Face_V3_QUEENSIE_Reinforced_PrusaMK4.stl
221.5 x 175.5 x 2.40
