brickrockler/surfclock/V5_PERFECT_CLICKLOCK_PRINT_KIT/4c_Back_Cover_FAST_1HR_CLEAR_WINDOW_PrusaMK4.stl

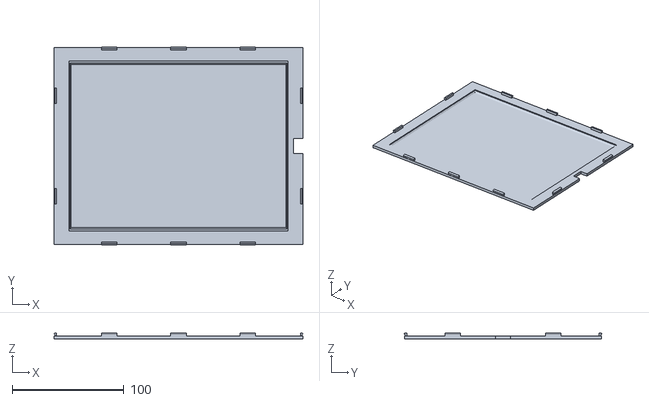
[picture p12: CAD file, 2026-10-15]
V5_PERFECT_CLICKLOCK_PRINT_KIT/4c_Back_Cover_FAST_1HR_CLEAR_WINDOW_PrusaMK4.stl
222.4 x 176.4 x 5.80
