brickrockler/surfclock/FINAL_PRINT_FILES/5a_OPTION1_FaceUp_FlatIronedTop_Extended_Hands_PrusaMINI.stl

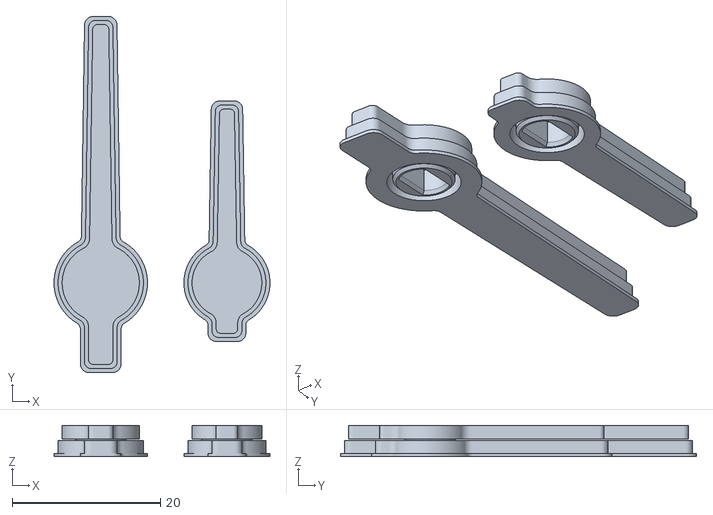
[picture p13: CAD file, 2026-10-15]
FINAL_PRINT_FILES/5a_OPTION1_FaceUp_FlatIronedTop_Extended_Hands_PrusaMINI.stl
29.1 x 48.0 x 4.20
