brickrockler/surfclock/V5_PERFECT_CLICKLOCK_PRINT_KIT/4b_Back_Cover_BRAUN_LOUVERED_HiddenClips_PrusaMK4.stl

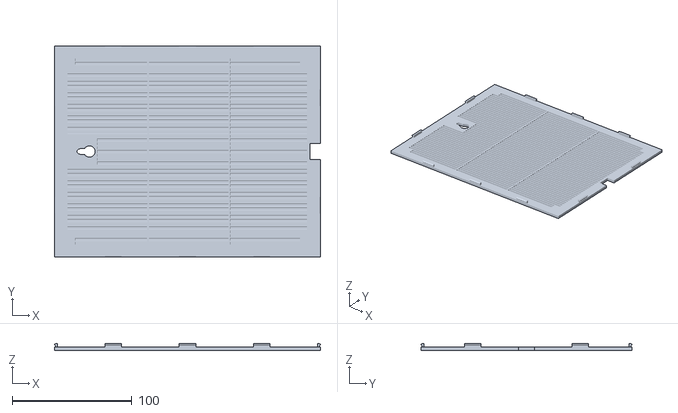
[picture p14: CAD file, 2026-10-15]
V5_PERFECT_CLICKLOCK_PRINT_KIT/4b_Back_Cover_BRAUN_LOUVERED_HiddenClips_PrusaMK4.stl
222.4 x 176.4 x 5.80
