brickrockler/surfclock/V5_PERFECT_CLICKLOCK_PRINT_KIT/scripts/hand_upper_centered.stl

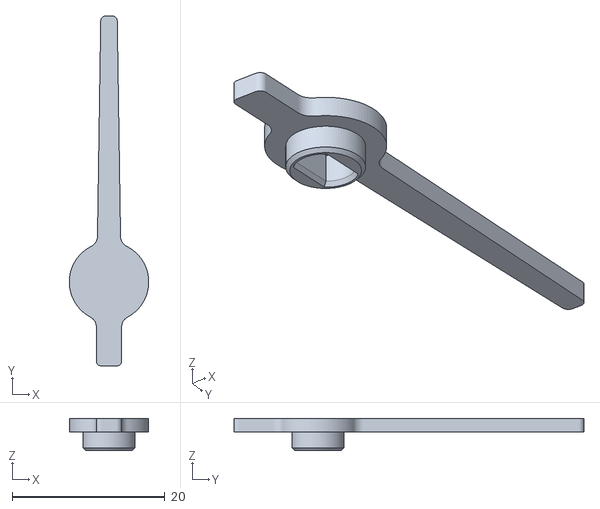
[picture p15: CAD file, 2026-10-15]
V5_PERFECT_CLICKLOCK_PRINT_KIT/scripts/hand_upper_centered.stl
10.4 x 45.8 x 4.20
