brickrockler/surfclock/V6_FIXED_Motor_Mount_Plate_ZeroStringing_PrusaMK4.stl

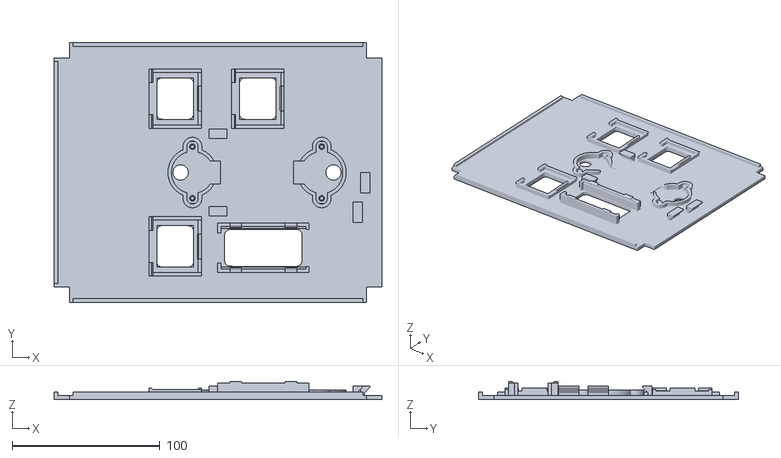
[picture p16: CAD file, 2026-10-15]
V6_FIXED_Motor_Mount_Plate_ZeroStringing_PrusaMK4.stl
222.0 x 176.0 x 12.5
