brickrockler/surfclock/1_Outer_Frame_V3_Tiny_Corner_Pilot_Holes_PrusaMK4.stl

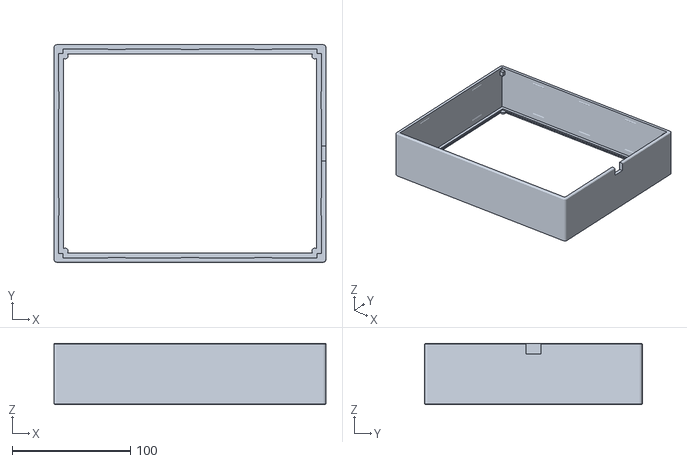
[picture p18: CAD file, 2026-10-15]
1_Outer_Frame_V3_Tiny_Corner_Pilot_Holes_PrusaMK4.stl
230.0 x 184.0 x 52.0
