brickrockler/surfclock/V5_PERFECT_CLICKLOCK_PRINT_KIT/scripts/dial_text_black.stl

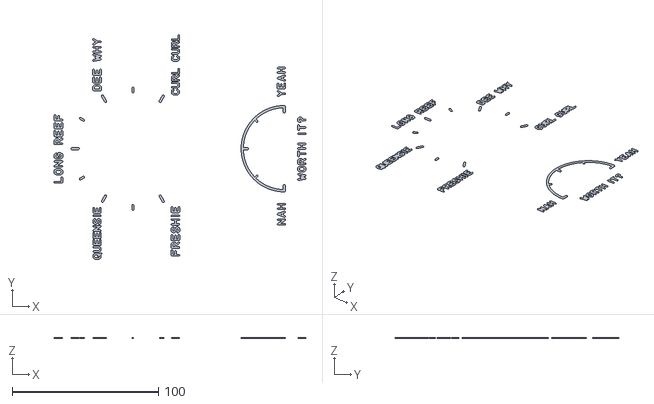
[picture p19: CAD file, 2026-10-15]
V5_PERFECT_CLICKLOCK_PRINT_KIT/scripts/dial_text_black.stl
172.3 x 153.6 x 0.58
