brickrockler/surfclock/04_conditions_hand_28byj48_capped.stl

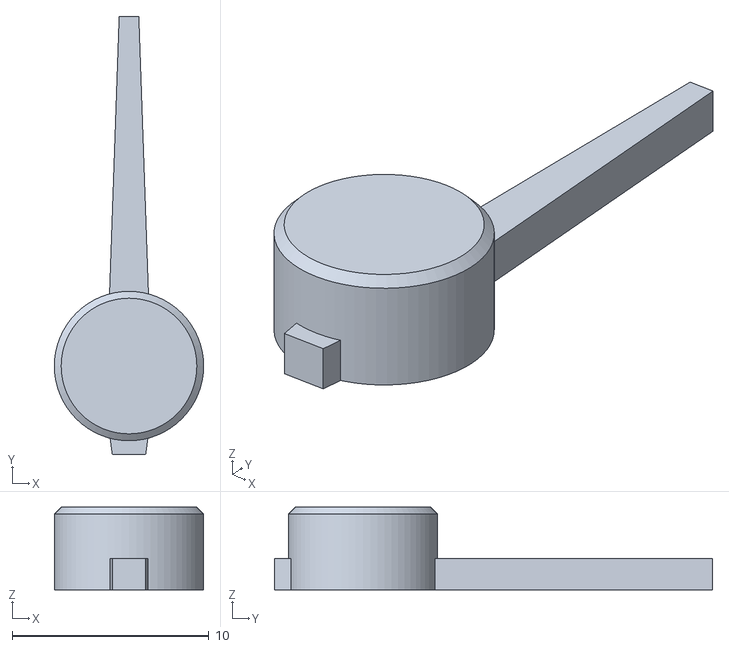
[picture p20: CAD file, 2026-10-15]
04_conditions_hand_28byj48_capped.stl
7.60 x 22.3 x 4.20
