brickrockler/surfclock/FINAL_PRINT_FILES/5_Pointer_Hands_MATTE_ORANGE_PrusaMINI.stl

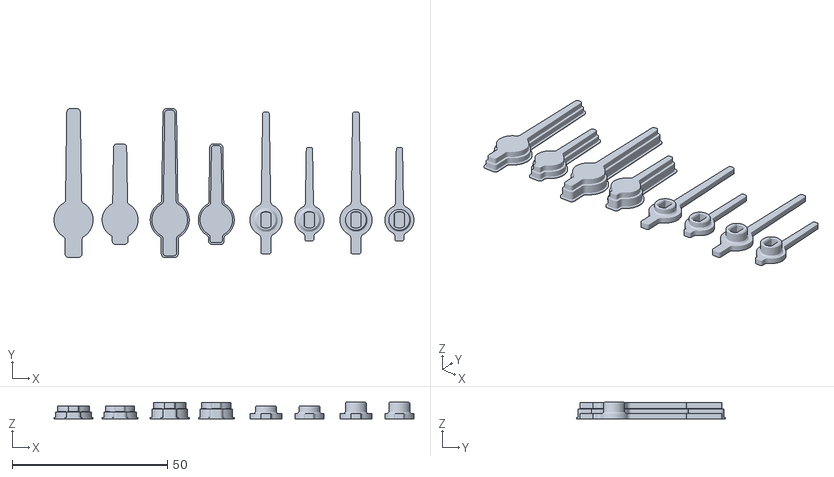
[picture p21: CAD file, 2026-10-15]
FINAL_PRINT_FILES/5_Pointer_Hands_MATTE_ORANGE_PrusaMINI.stl
116.0 x 48.0 x 5.40
