brickrockler/surfclock/5_MOTOR_SHAFT_EXTENSION_POSTS_FOR_6MM_DIAL_HOLE_PrusaMINI.stl

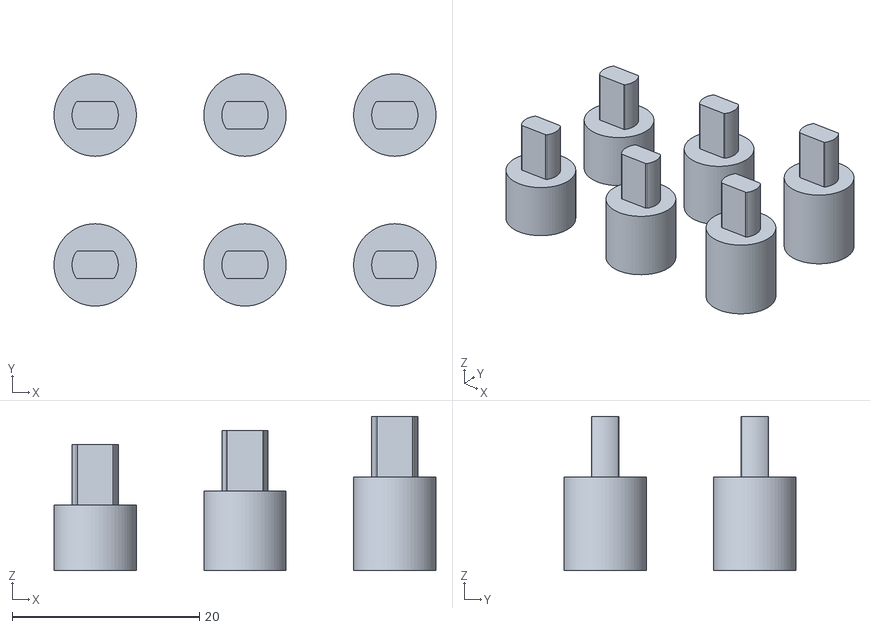
[picture p22: CAD file, 2026-10-15]
5_MOTOR_SHAFT_EXTENSION_POSTS_FOR_6MM_DIAL_HOLE_PrusaMINI.stl
40.8 x 24.8 x 16.5
