brickrockler/surfclock/2_OPTIONAL_Dial_Face_With_Subdial_Basin_Ring.stl

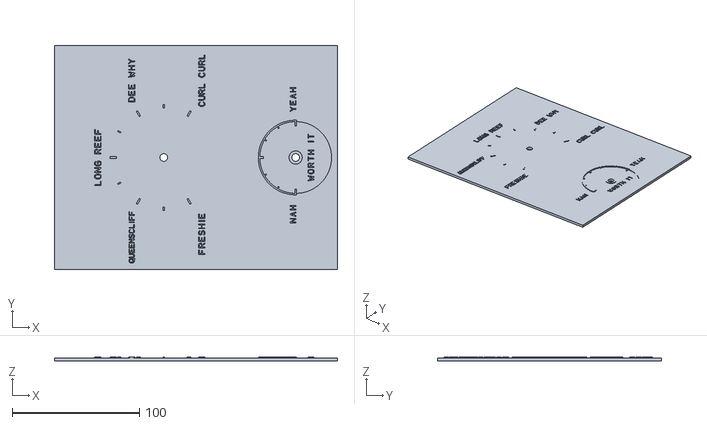
[picture p23: CAD file, 2026-10-15]
2_OPTIONAL_Dial_Face_With_Subdial_Basin_Ring.stl
222.1 x 176.1 x 3.00
