brickrockler/surfclock/FINAL_PRINT_FILES/5_AND_6_COMBINED_Hands_Plus_Snap_Pins_PrusaMINI.stl

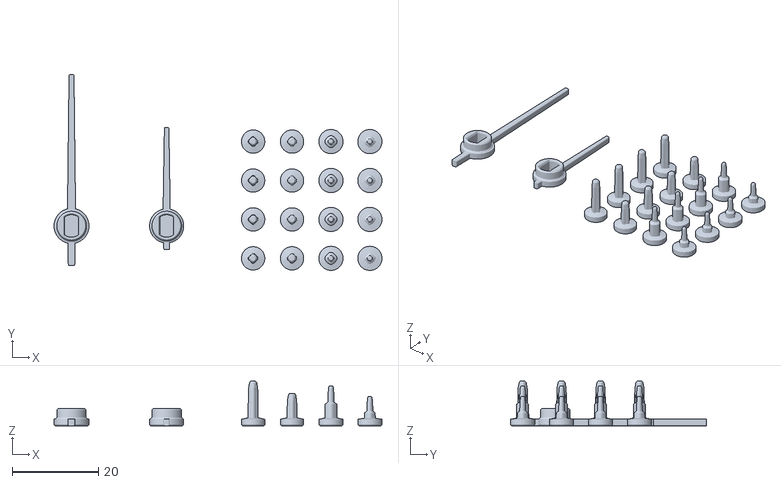
[picture p24: CAD file, 2026-10-15]
FINAL_PRINT_FILES/5_AND_6_COMBINED_Hands_Plus_Snap_Pins_PrusaMINI.stl
75.8 x 45.3 x 10.3
