brickrockler/surfclock/05_rear_cover_usb.stl

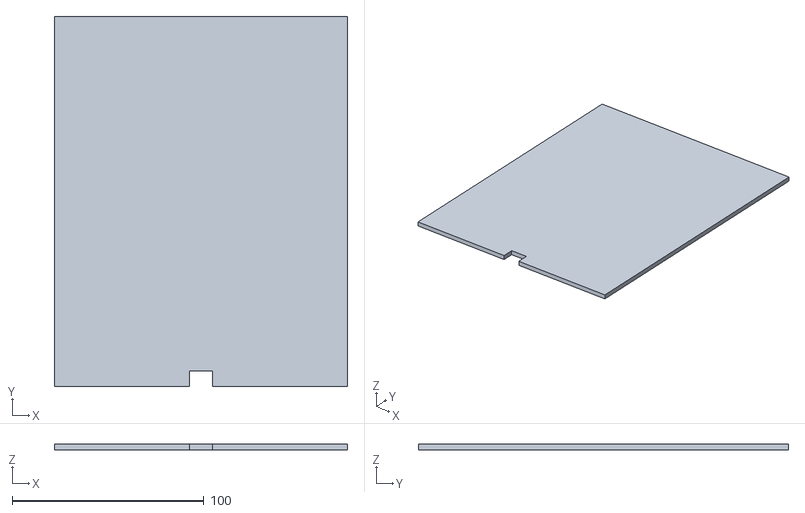
[picture p25: CAD file, 2026-10-15]
05_rear_cover_usb.stl
153.1 x 193.1 x 3.00
