brickrockler/surfclock/FINAL_PRINT_FILES/5_Skinny_Elegant_Extended_Hands_PrusaMINI.stl

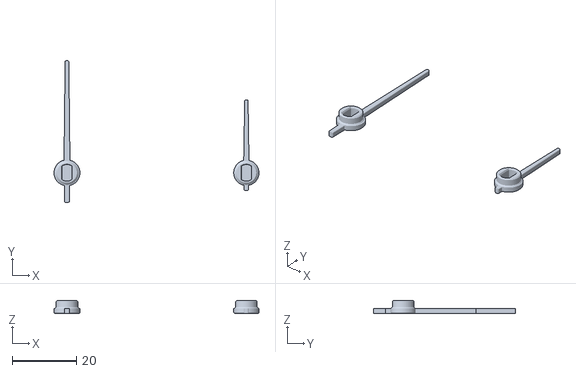
[picture p26: CAD file, 2026-10-15]
FINAL_PRINT_FILES/5_Skinny_Elegant_Extended_Hands_PrusaMINI.stl
64.0 x 44.2 x 4.00
