brickrockler/surfclock/0_FIX_TODAY_Wide_Hub_Hands_Plus_Spindle_Rings_PrusaMINI.stl

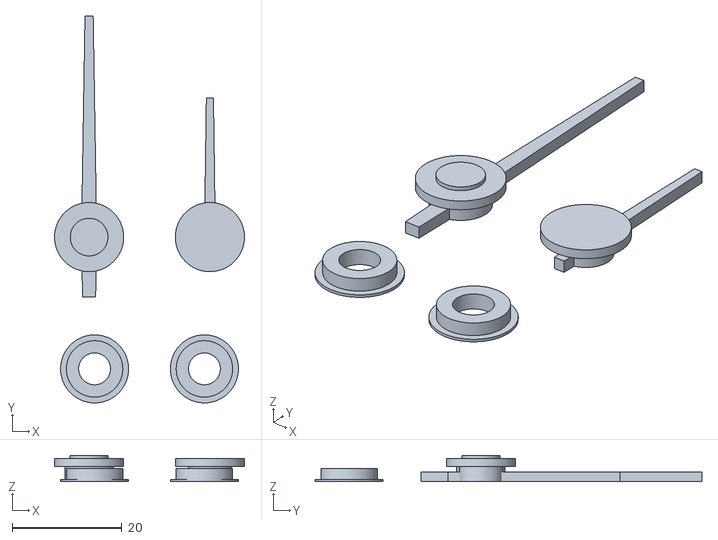
[picture p27: CAD file, 2026-10-15]
0_FIX_TODAY_Wide_Hub_Hands_Plus_Spindle_Rings_PrusaMINI.stl
34.6 x 70.5 x 4.80
