brickrockler/surfclock/03_beach_hand_28byj48_capped.stl

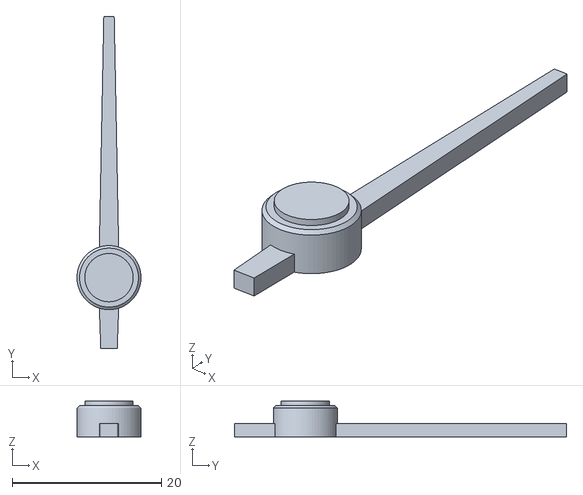
[picture p29: CAD file, 2026-10-15]
03_beach_hand_28byj48_capped.stl
8.60 x 44.5 x 4.80
