brickrockler/surfclock/Surf_Clock_3D_Model.stl

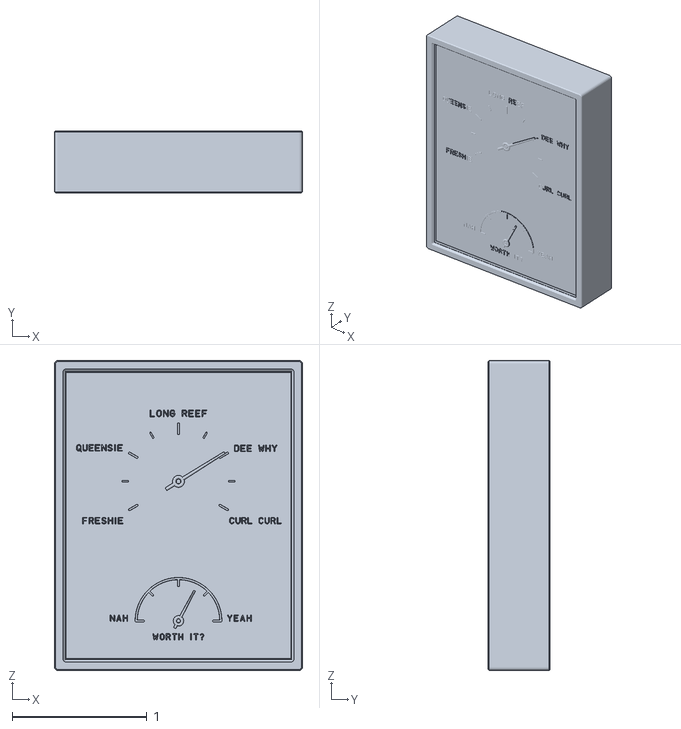
[picture p30: CAD file, 2026-10-15]
Surf_Clock_3D_Model.stl
1.84 x 0.46 x 2.30
