brickrockler/surfclock/FINAL_PRINT_FILES/5b_OPTION2_FaceDown_SmoothBedTop_Extended_Hands_PrusaMINI.stl

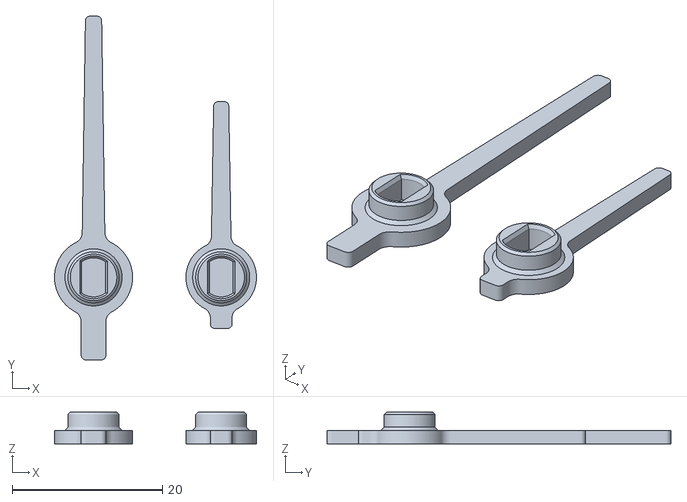
[picture p31: CAD file, 2026-10-15]
FINAL_PRINT_FILES/5b_OPTION2_FaceDown_SmoothBedTop_Extended_Hands_PrusaMINI.stl
26.9 x 45.8 x 4.20
