brickrockler/surfclock/FINAL_PRINT_FILES/3_Motor_Mount_Plate_ORANGE_or_WHITE_PrusaMK4.stl

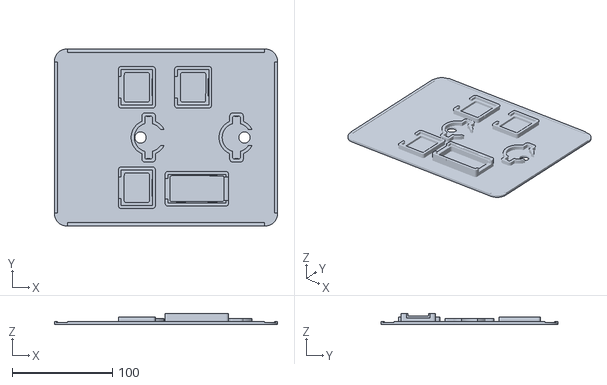
[picture p32: CAD file, 2026-10-15]
FINAL_PRINT_FILES/3_Motor_Mount_Plate_ORANGE_or_WHITE_PrusaMK4.stl
222.0 x 176.0 x 11.4
