brickrockler/surfclock/FINAL_PRINT_FILES/5_Skinny_Elegant_Extended_Hands_Pure_FaceUp_PrusaMINI.stl

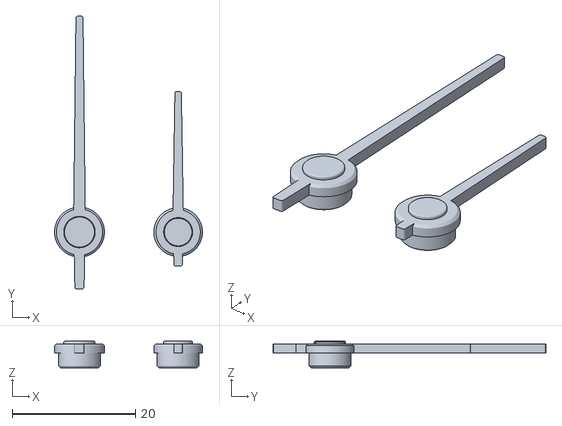
[picture p33: CAD file, 2026-10-15]
FINAL_PRINT_FILES/5_Skinny_Elegant_Extended_Hands_Pure_FaceUp_PrusaMINI.stl
24.0 x 44.2 x 4.35
