brickrockler/surfclock/5_EXTENDED_SHAFT_HANDS_AND_COUPLERS_PrusaMINI.stl

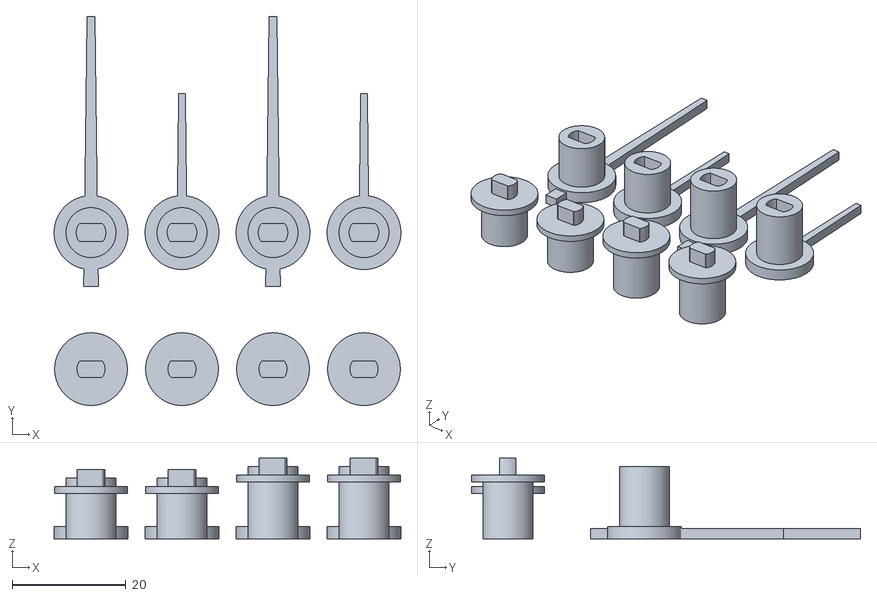
[picture p34: CAD file, 2026-10-15]
5_EXTENDED_SHAFT_HANDS_AND_COUPLERS_PrusaMINI.stl
61.0 x 68.4 x 14.2
