brickrockler/surfclock/01_outer_bezel_chassis.stl

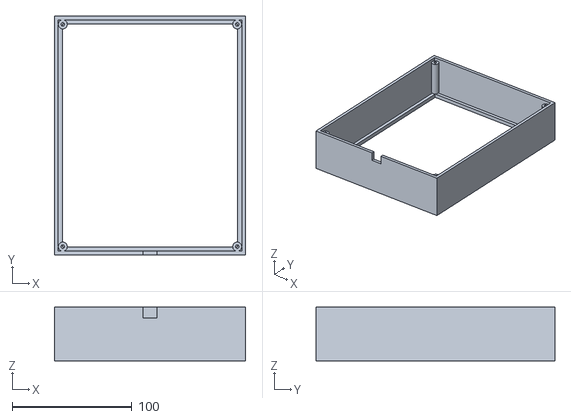
[picture p35: CAD file, 2026-10-15]
01_outer_bezel_chassis.stl
160.0 x 200.0 x 45.0
