brickrockler/surfclock/4_Back_Cover_V3_CORFLUTE_FLUTED_PrusaMK4.stl

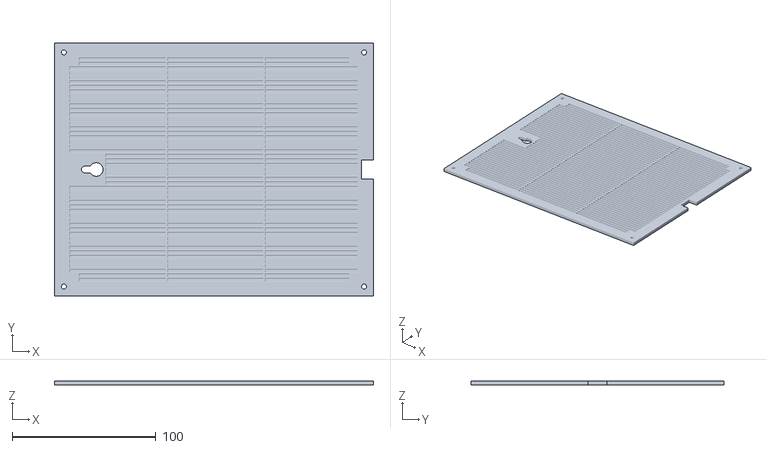
[picture p36: CAD file, 2026-10-15]
4_Back_Cover_V3_CORFLUTE_FLUTED_PrusaMK4.stl
222.1 x 176.1 x 3.00
