brickrockler/surfclock/06_dual_stepper_carrier_plate.stl

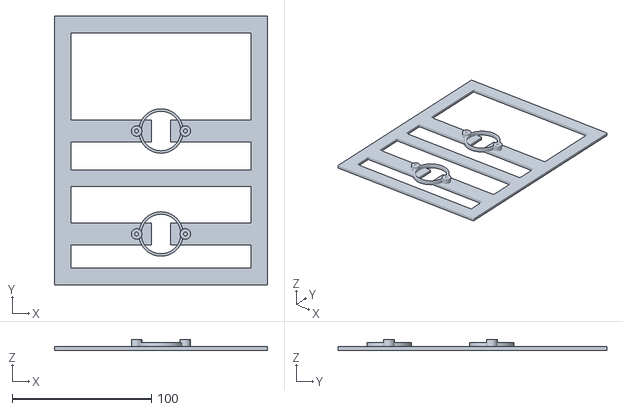
[picture p37: CAD file, 2026-10-15]
06_dual_stepper_carrier_plate.stl
153.1 x 193.1 x 7.60
