brickrockler/surfclock/02b_dial_text_and_arc_only.stl

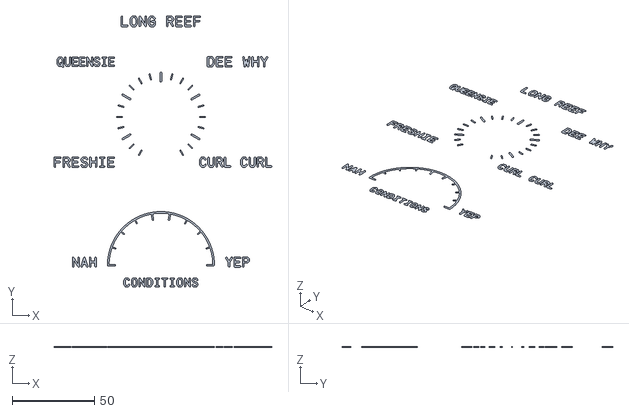
[picture p38: CAD file, 2026-10-15]
02b_dial_text_and_arc_only.stl
132.4 x 164.6 x 0.4
