brickrockler/surfclock/3_Motor_Mount_Plate_ORANGE_or_WHITE_PrusaMK4NEW.stl

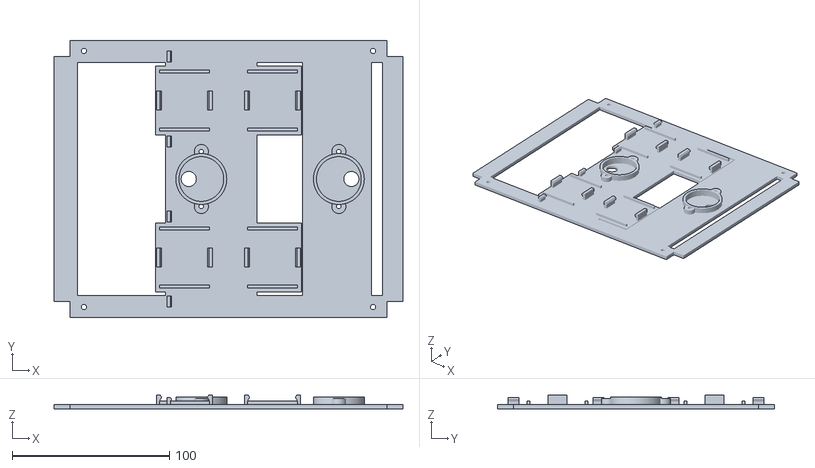
[picture p39: CAD file, 2026-10-15]
3_Motor_Mount_Plate_ORANGE_or_WHITE_PrusaMK4NEW.stl
222.1 x 176.1 x 8.90
