brickrockler/surfclock/3_Motor_Mount_Plate_V3_ESP32_WiderClips_PilotHoles_PrusaMK4.stl

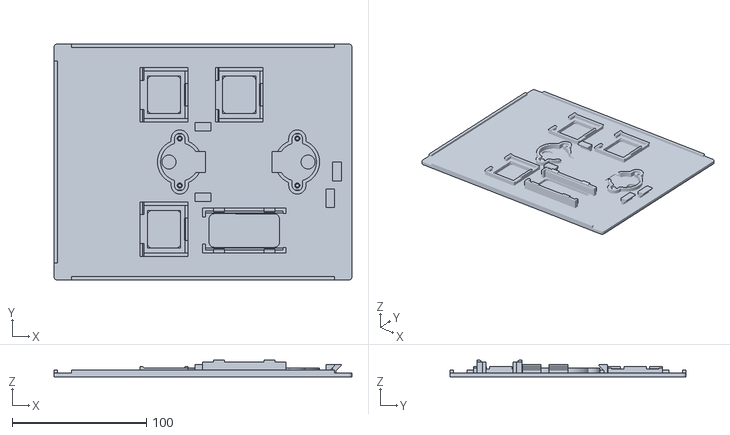
[picture p40: CAD file, 2026-10-15]
3_Motor_Mount_Plate_V3_ESP32_WiderClips_PilotHoles_PrusaMK4.stl
221.8 x 175.8 x 12.5
