brickrockler/surfclock/V8_FAST_50MIN_Motor_Mount_Plate_PrusaMK4.stl

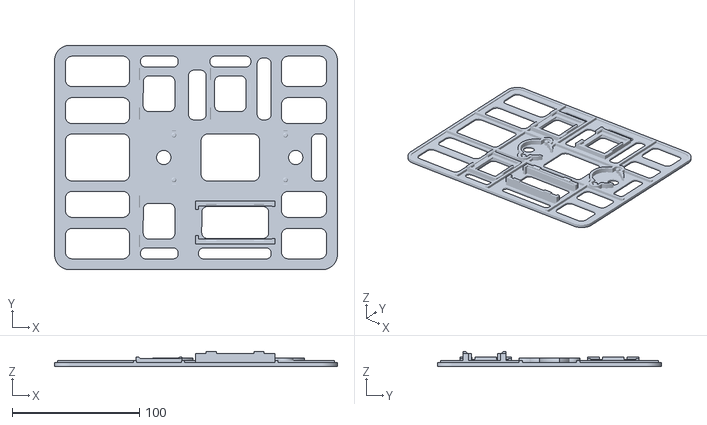
[picture p41: CAD file, 2026-10-15]
V8_FAST_50MIN_Motor_Mount_Plate_PrusaMK4.stl
222.0 x 176.0 x 11.4
