brickrockler/surfclock/(list of files, cad)

Other CAD files:
V5_PERFECT_CLICKLOCK_PRINT_KIT/scripts/dial_base_white.stl
2_Dial_Face_V3_QUEENSCLIFF_Reinforced_PrusaMK4.stl
V5_PERFECT_CLICKLOCK_PRINT_KIT/scripts/clean_base_plate.stl
FINAL_PRINT_FILES/2_OPTIONAL_Dial_Face_QUEENSCLIFF_Reinforced_PrusaMK4.stl
4_Back_Cover_TRANSPARENT_or_WHITE_PrusaMK4.stl
FINAL_PRINT_FILES/4_Back_Cover_TRANSPARENT_or_WHITE_PrusaMK4.stl
FINAL_PRINT_FILES/2_Dial_Face_WHITE_then_BLACK_at_Z2.6mm_PrusaMK4.stl
FINAL_PRINT_FILES/2_Dial_Face_V3_EASTERN_SUBURBS_Bondi_Bronte_Coogee_PrusaMK4.stl
NEW2_Dial_Face_V2_RAMS_ARCHITECTURAL_EDITION_PrusaMK4.stl
FINAL_PRINT_FILES/2_Dial_Face_V3_SYDNEY_ICONS_Bondi_Bronte_PrusaMK4.stl
FINAL_PRINT_FILES/1_Outer_Frame_MATTE_WHITE_PrusaMK4.stl
NEWNEWNEW2_Dial_Face_V2_RAMS_ARCHITECTURAL_EDITION_PrusaMK4.stl
FINAL_PRINT_FILES/4_OPTIONAL_Back_Cover_PURE_FLAT_TRANSLUCENT_PrusaMK4.stl
4_OPTIONAL_Back_Cover_PURE_FLAT_TRANSLUCENT_PrusaMK4.stl
2_Dial_Face_WHITE_then_BLACK_at_Z2.6mm_PrusaMK4.stl
2_Dial_Face_V2_FLAT_RAMS_EDITION_PrusaMK4.stl
2_Dial_Face_V3_EASTERN_SUBURBS_Bondi_Bronte_Coogee_PrusaMK4.stl
2_Dial_Face_V3_SYDNEY_ICONS_Bondi_Bronte_PrusaMK4.stl
2_Dial_Face_V2_RAMS_ARCHITECTURAL_EDITION_PrusaMK4.stl
2_Dial_Face_V2_BIGGER_CRISP_TEXT_AND_6MM_HOLE_PrusaMK4.stl
1_Outer_Frame_MATTE_WHITE_PrusaMK4.stl
cad/surf_clock_monolith.scad
web_customizer/downloads/cad/surf_clock_monolith.scad
6_Snap_Lock_Pins_No_Screws_Needed.stl
C4D_USD_OCTANE_STUDIO_EXPORTS/SurfClock_184x230x46mm_60fps_8K_AppleKeynote_Stage.blend
FINAL_PRINT_FILES/6_Snap_Lock_Pins_No_Screws_Needed.stl
SURF_CLOCK_V6_INTERACTIVE_INSPECTION.blend
SurfClock_001_Live_Interactive_Design_Playback.blend
SurfClock_0_to_100_Design_Evolution_Master.blend
SurfClock_0_to_100_Design_Evolution_V2_Master.blend
SurfClock_Airy_Coastal_Timber_Master.blend
SurfClock_Airy_Coastal_Timber_V2_Master.blend
SurfClock_Airy_Coastal_Timber_V3_Dynamic_Master.blend
SurfClock_Amber_Gradient_MultiColorway_Master.blend
SurfClock_Amber_Gradient_V2_Master.blend
SurfClock_Authentic_Gallery_Master_V8.blend
SurfClock_AutoCAD_Wireframe_Surfer.blend
SurfClock_Coastal_Louver_Master.blend
SurfClock_Dribbble_OP1_Master.blend
SurfClock_HowItWasMade_5Act_Surgical_V5.blend
SurfClock_Interactive_CAD_Master_V9.blend
SurfClock_Live_Interactive_Choreography.blend
SurfClock_Lookdev_Cinema_V4_Master.blend
SurfClock_Lookdev_Cinema_V5_Clean_Master.blend
SurfClock_Master_8K_Edition.blend
SurfClock_NorthStar_Studio_Master.blend
SurfClock_Oak_Workbench_Flatlay_Master.blend
SurfClock_Tactile_Sunlit_Master.blend
SurfClock_True3D_Displaced_Plaster_Master_Suite.blend
SurfClock_UltraReal_Unified_Warm_Atelier_V7.blend
SurfClock_Ultra_Craft_100Pct_Master.blend
SurfClock_Ultra_Technical_Exploded_Master.blend
SurfClock_Ultra_Technical_Exploded_V2_Master.blend
SurfClock_V13_GoldenHour_Master.blend
SurfClock_V13_GoldenHour_Master_PRE_V24_BACKUP.blend
SurfClock_V23_ActualPhysicalTypeface_Master.blend
SurfClock_Vitsoe606_Study_Master.blend
Surf_Clock_3D_Model.obj
web_customizer/downloads/stl/02a_dial_faceplate_with_text.stl
web_customizer/downloads/stl/02b_dial_text_and_arc_only.stl
web_customizer/downloads/stl/03_beach_hand_28byj48_capped.stl
web_customizer/downloads/stl/04_conditions_hand_28byj48_capped.stl
web_customizer/downloads/stl/05_rear_cover_usb.stl
web_customizer/downloads/stl/2_Dial_Face_V3_EASTERN_SUBURBS_Bondi_Bronte_Coogee_PrusaMK4.stl
web_customizer/downloads/stl/2_Dial_Face_V3_SYDNEY_ICONS_Bondi_Bronte_PrusaMK4.stl
