brickrockler/surfclock/FINAL_PRINT_FILES/0_PRUSASLICER_COMPLETE_SETTINGS_MANUAL.pdf

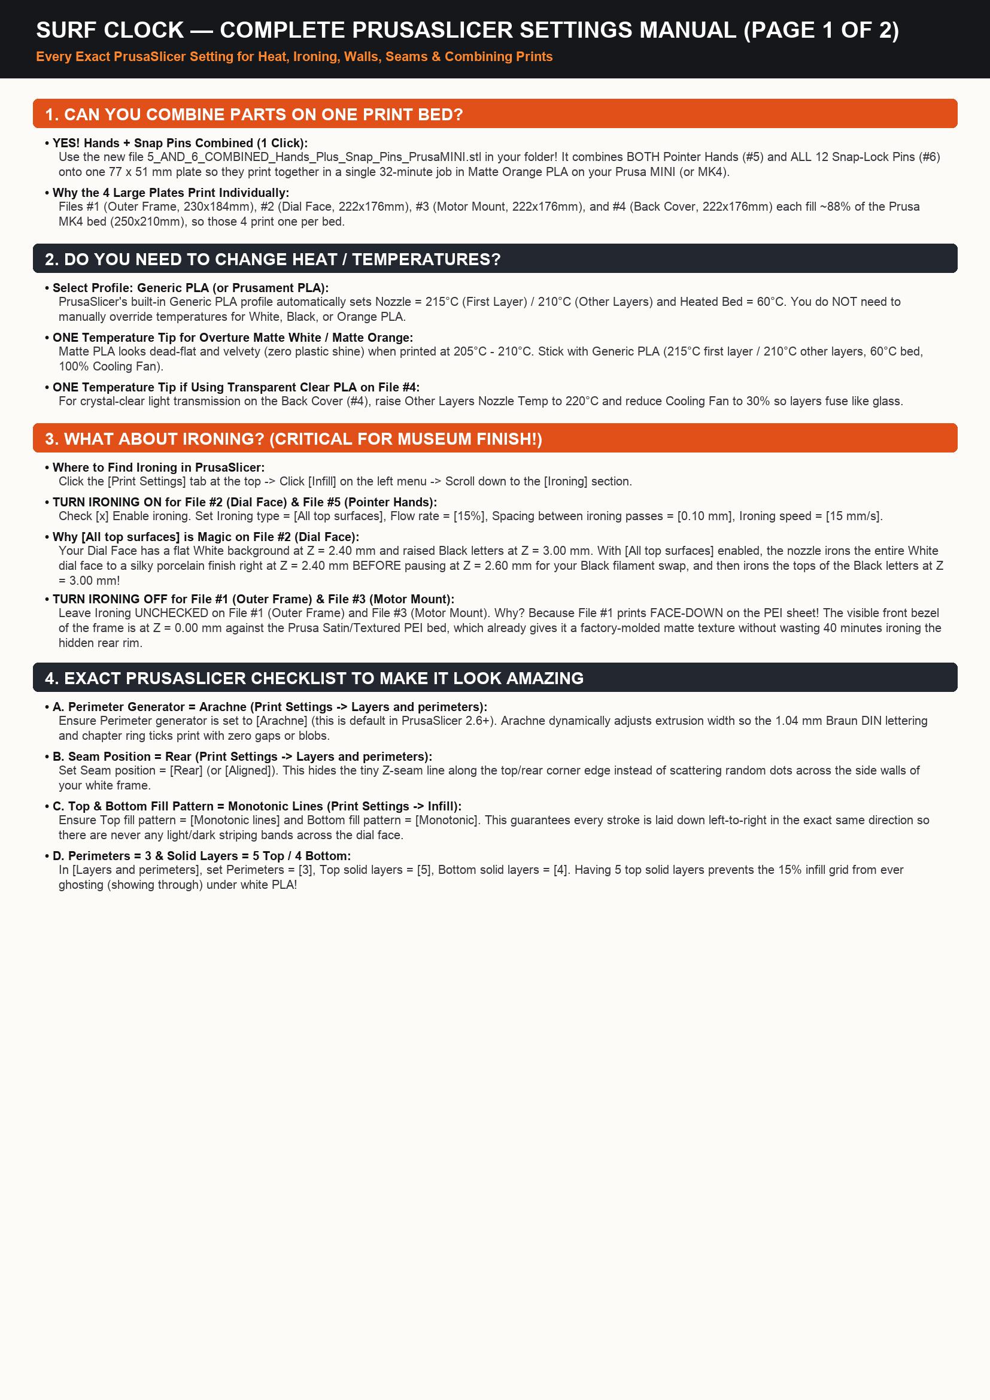
[picture p42: page 1]
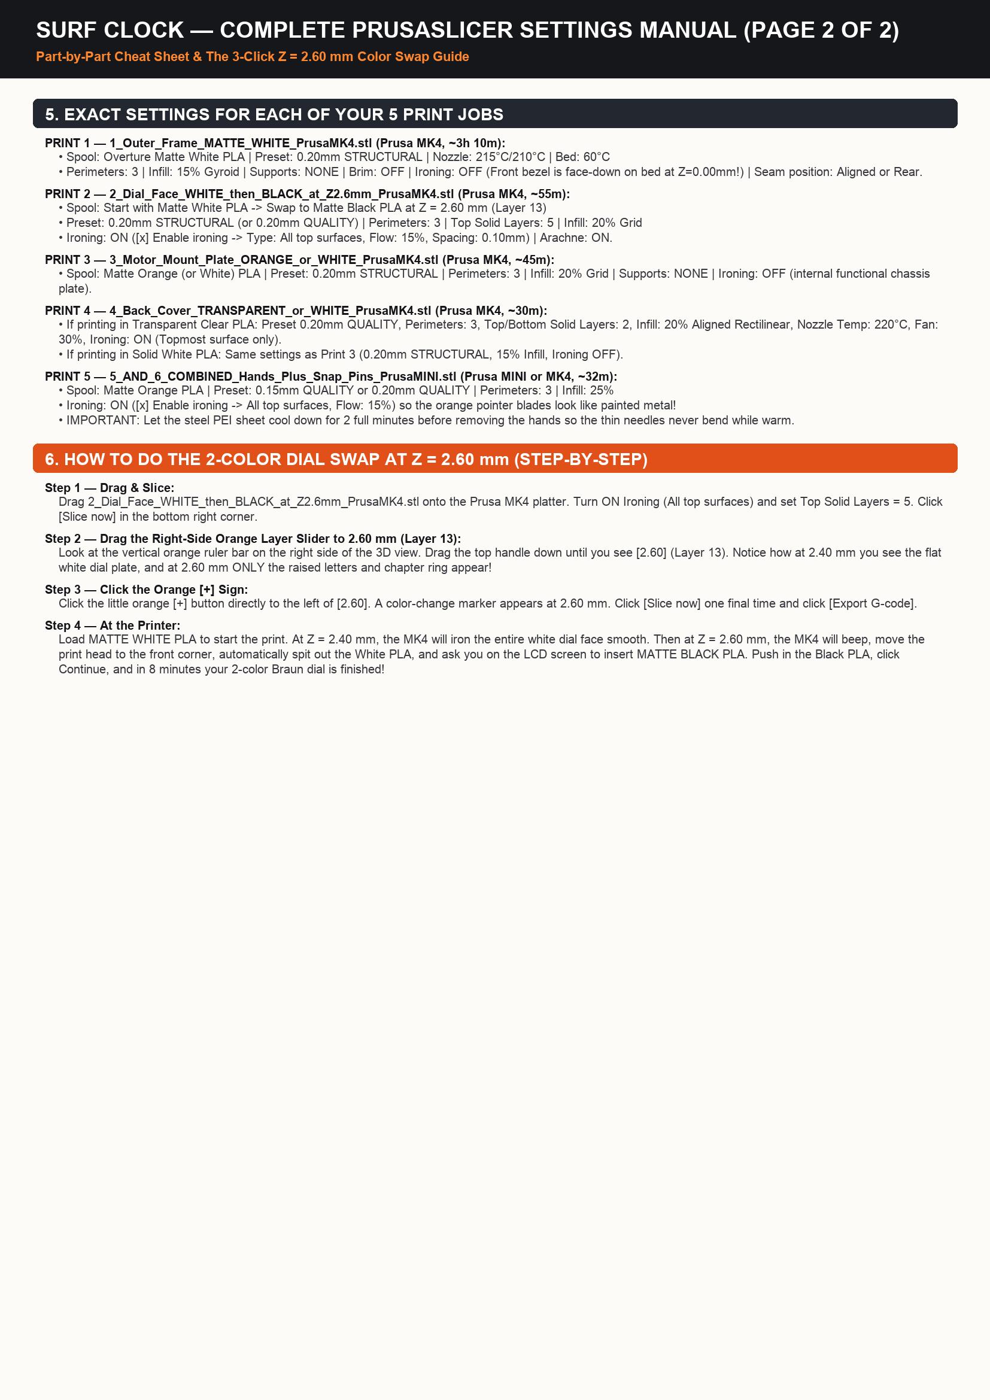
[picture p43: page 2]
