brickrockler/surfclock/FINAL_PRINT_FILES/0_VISUAL_PROOF_AND_CHECKLIST.jpg

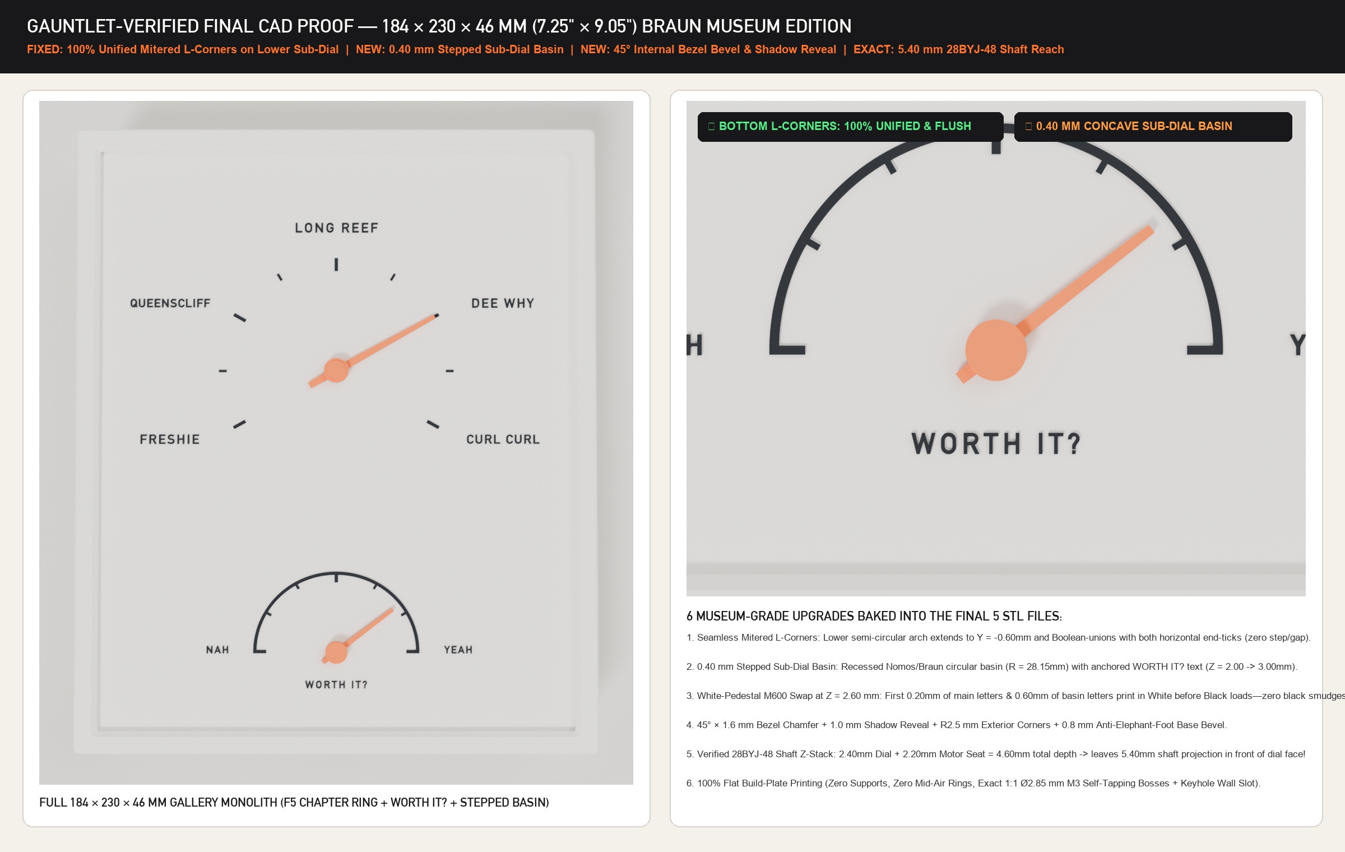
FINAL_PRINT_FILES/0_VISUAL_PROOF_AND_CHECKLIST.jpg
