brickrockler/surfclock/FINAL_PRINT_FILES/PHOTOGRAPHY_LOOKBOOK/00_MASTER_10_SHOT_STUDIO_LOOKBOOK_SHEET.jpg

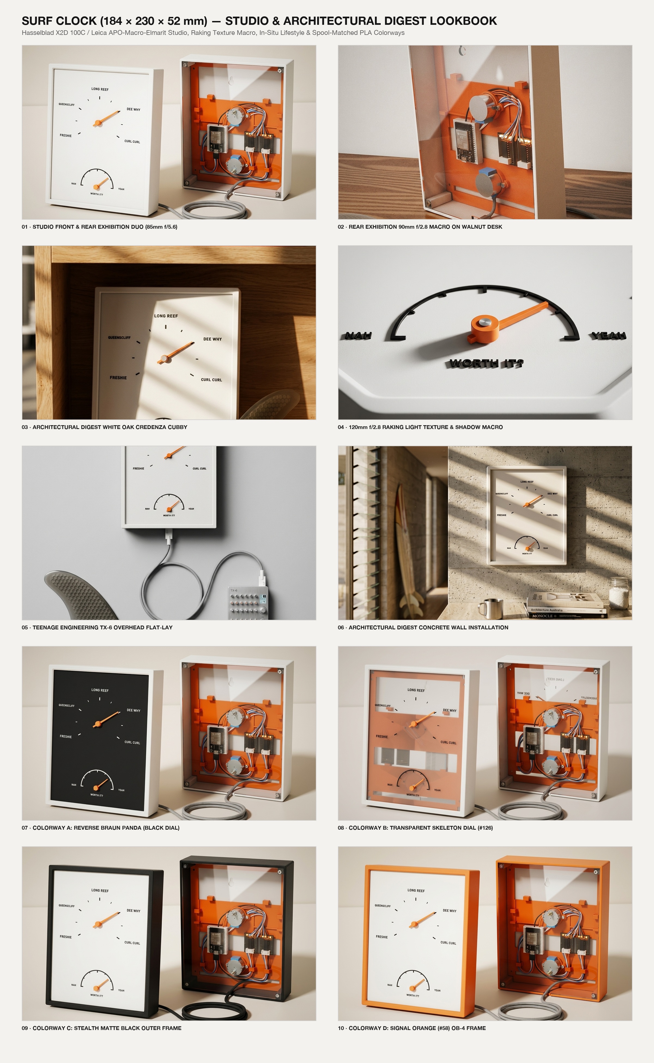
FINAL_PRINT_FILES/PHOTOGRAPHY_LOOKBOOK/00_MASTER_10_SHOT_STUDIO_LOOKBOOK_SHEET.jpg
