brickrockler/surfclock/FINAL_PRINT_FILES/PHOTOGRAPHY_LOOKBOOK/01_Studio_Front_and_Rear_Exhibition_Duo.jpg

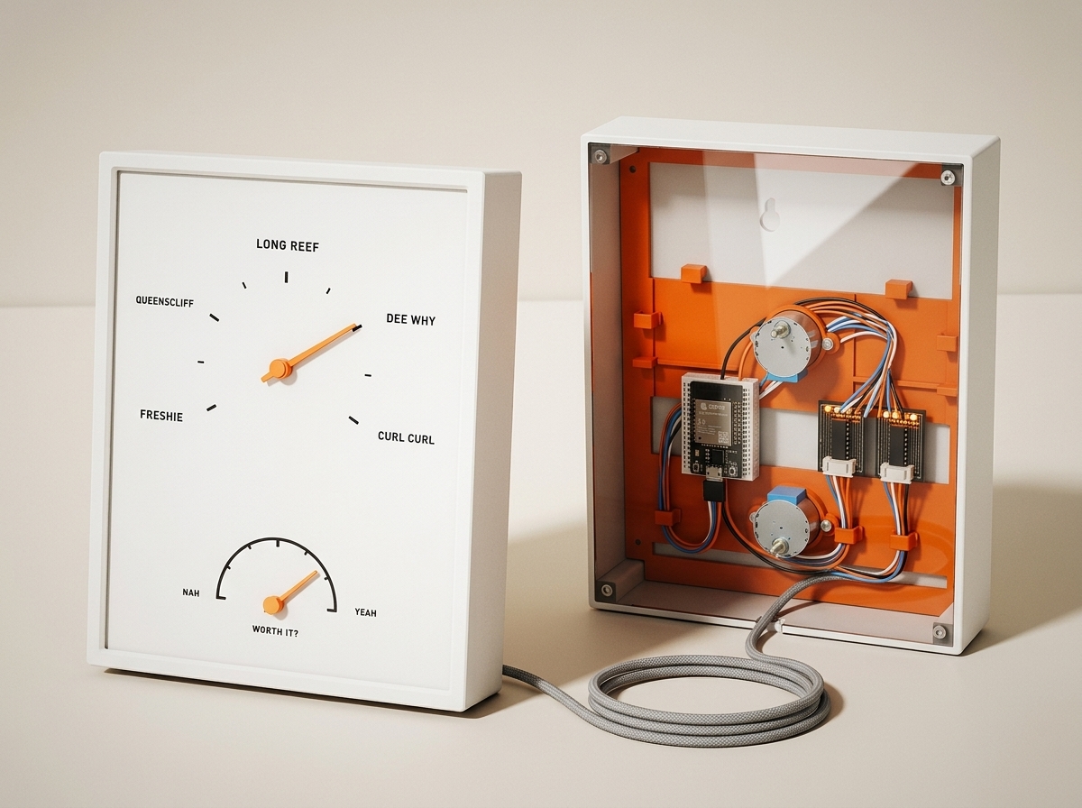
FINAL_PRINT_FILES/PHOTOGRAPHY_LOOKBOOK/01_Studio_Front_and_Rear_Exhibition_Duo.jpg
