brickrockler/surfclock/FINAL_PRINT_FILES/PHOTOGRAPHY_LOOKBOOK/02_Rear_Exhibition_Macro_Walnut_Desk.jpg

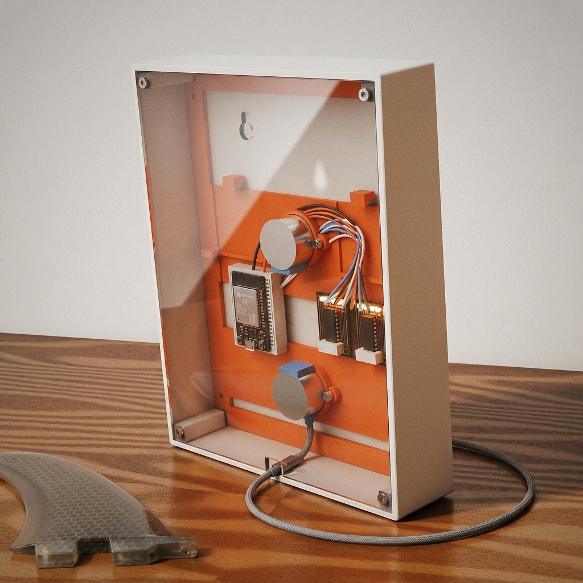
FINAL_PRINT_FILES/PHOTOGRAPHY_LOOKBOOK/02_Rear_Exhibition_Macro_Walnut_Desk.jpg
