brickrockler/surfclock/FINAL_PRINT_FILES/PHOTOGRAPHY_LOOKBOOK/03_Architectural_Digest_White_Oak_Credenza.jpg

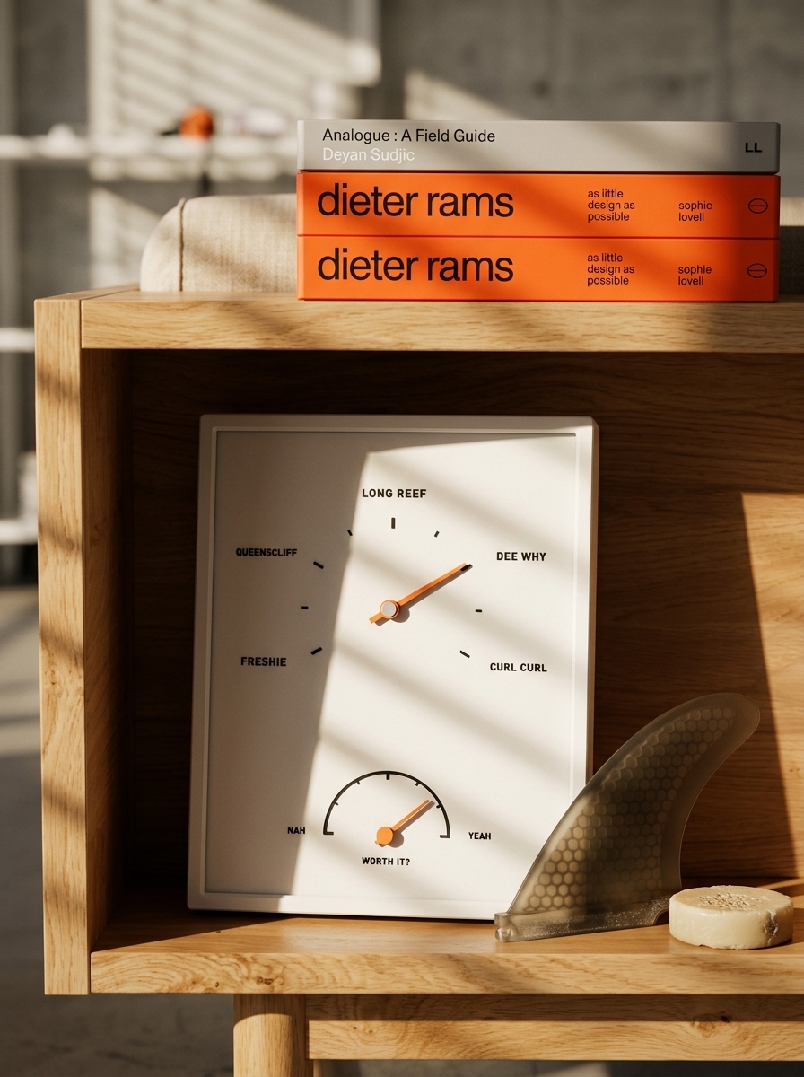
FINAL_PRINT_FILES/PHOTOGRAPHY_LOOKBOOK/03_Architectural_Digest_White_Oak_Credenza.jpg
