brickrockler/surfclock/FINAL_PRINT_FILES/PHOTOGRAPHY_LOOKBOOK/04_Raking_Light_Texture_Shadow_Macro.jpg

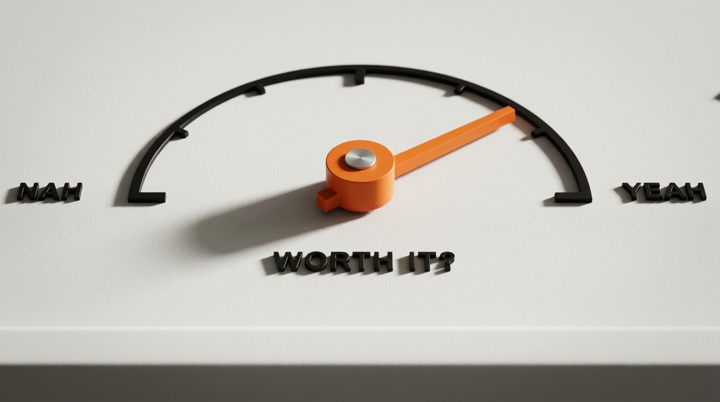
FINAL_PRINT_FILES/PHOTOGRAPHY_LOOKBOOK/04_Raking_Light_Texture_Shadow_Macro.jpg
