brickrockler/surfclock/FINAL_PRINT_FILES/PHOTOGRAPHY_LOOKBOOK/05_Teenage_Engineering_Overhead_Flatlay.jpg

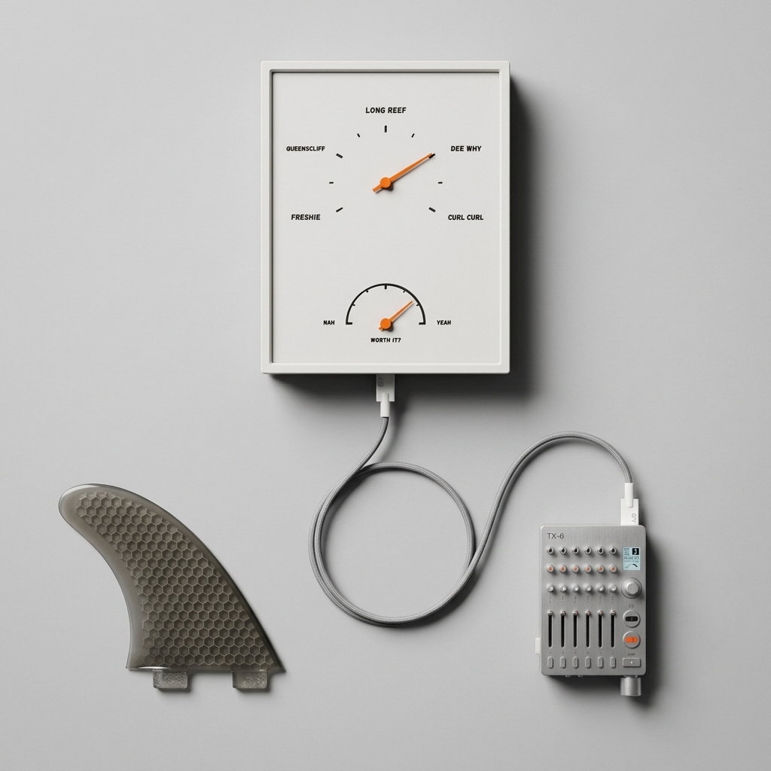
FINAL_PRINT_FILES/PHOTOGRAPHY_LOOKBOOK/05_Teenage_Engineering_Overhead_Flatlay.jpg
