brickrockler/surfclock/FINAL_PRINT_FILES/PHOTOGRAPHY_LOOKBOOK/06_Architectural_Digest_Concrete_Kitchen_Wall.jpg

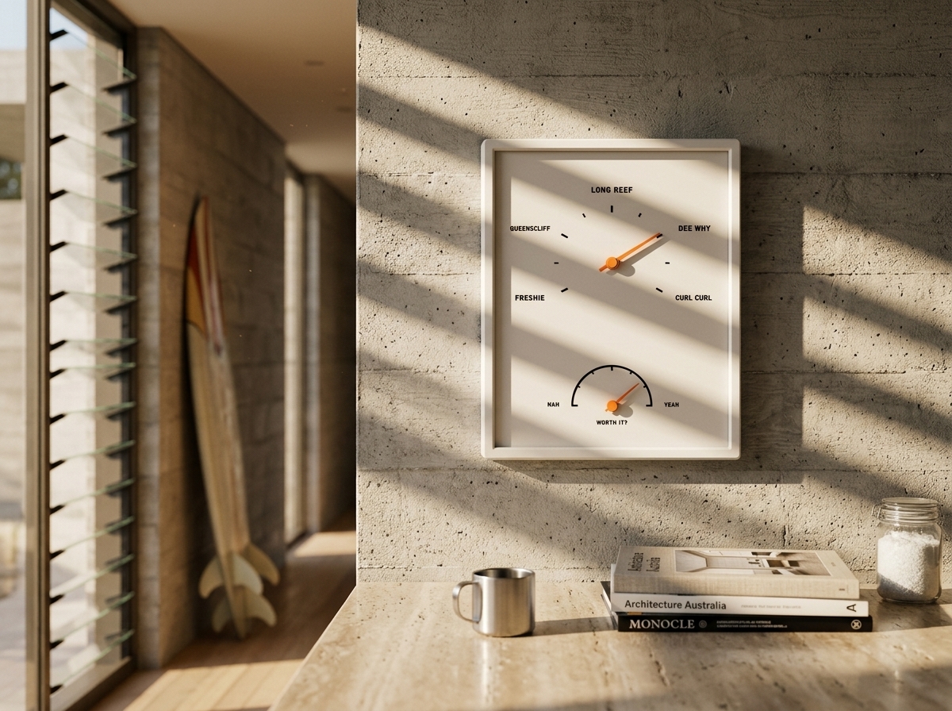
FINAL_PRINT_FILES/PHOTOGRAPHY_LOOKBOOK/06_Architectural_Digest_Concrete_Kitchen_Wall.jpg
