brickrockler/surfclock/FINAL_PRINT_FILES/PHOTOGRAPHY_LOOKBOOK/07_Colorway_A_Reverse_Braun_Panda.jpg

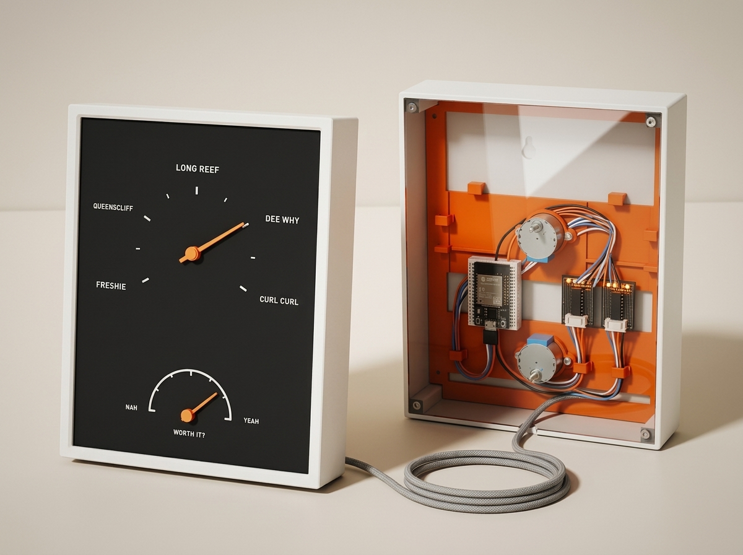
FINAL_PRINT_FILES/PHOTOGRAPHY_LOOKBOOK/07_Colorway_A_Reverse_Braun_Panda.jpg
