brickrockler/surfclock/FINAL_PRINT_FILES/PHOTOGRAPHY_LOOKBOOK/08_Colorway_B_Transparent_Skeleton_Dial.jpg

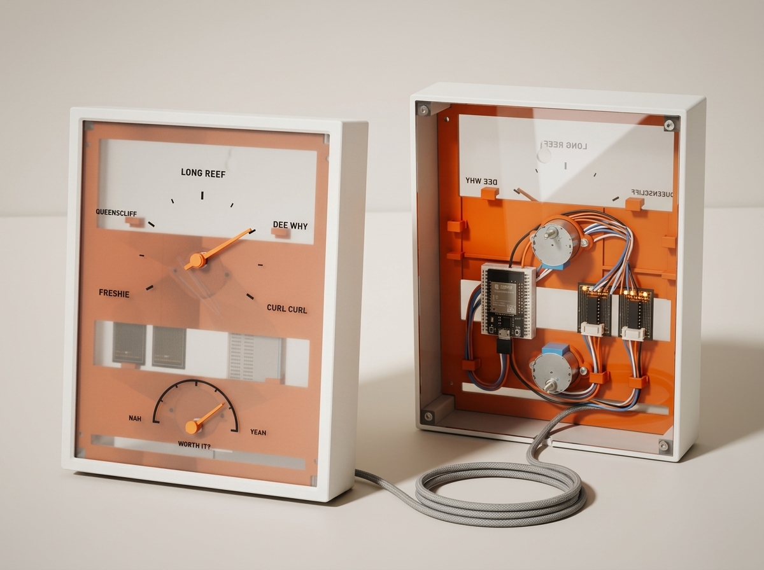
FINAL_PRINT_FILES/PHOTOGRAPHY_LOOKBOOK/08_Colorway_B_Transparent_Skeleton_Dial.jpg
