brickrockler/surfclock/FINAL_PRINT_FILES/PHOTOGRAPHY_LOOKBOOK/09_Colorway_C_Stealth_Matte_Black_Frame.jpg

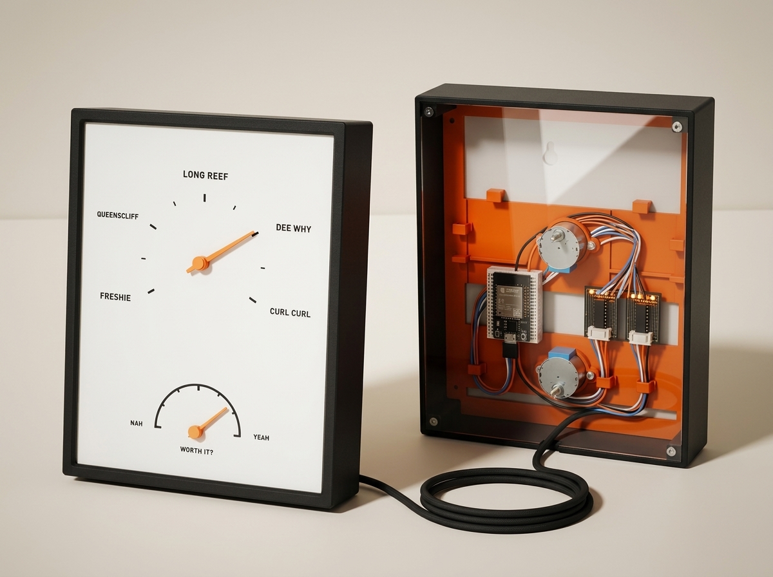
FINAL_PRINT_FILES/PHOTOGRAPHY_LOOKBOOK/09_Colorway_C_Stealth_Matte_Black_Frame.jpg
