brickrockler/surfclock/FINAL_PRINT_FILES/PHOTOGRAPHY_LOOKBOOK/10_Colorway_D_Signal_Orange_OB4_Frame.jpg

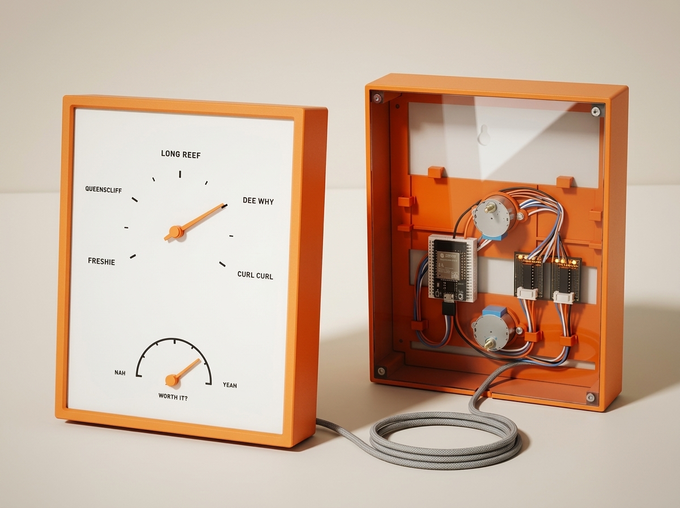
FINAL_PRINT_FILES/PHOTOGRAPHY_LOOKBOOK/10_Colorway_D_Signal_Orange_OB4_Frame.jpg
