brickrockler/surfclock/FINAL_PRINT_FILES/PHOTOGRAPHY_LOOKBOOK/11_Bondi_Penthouse_Travertine_Ribbed_Clear_Back_Duo.jpg

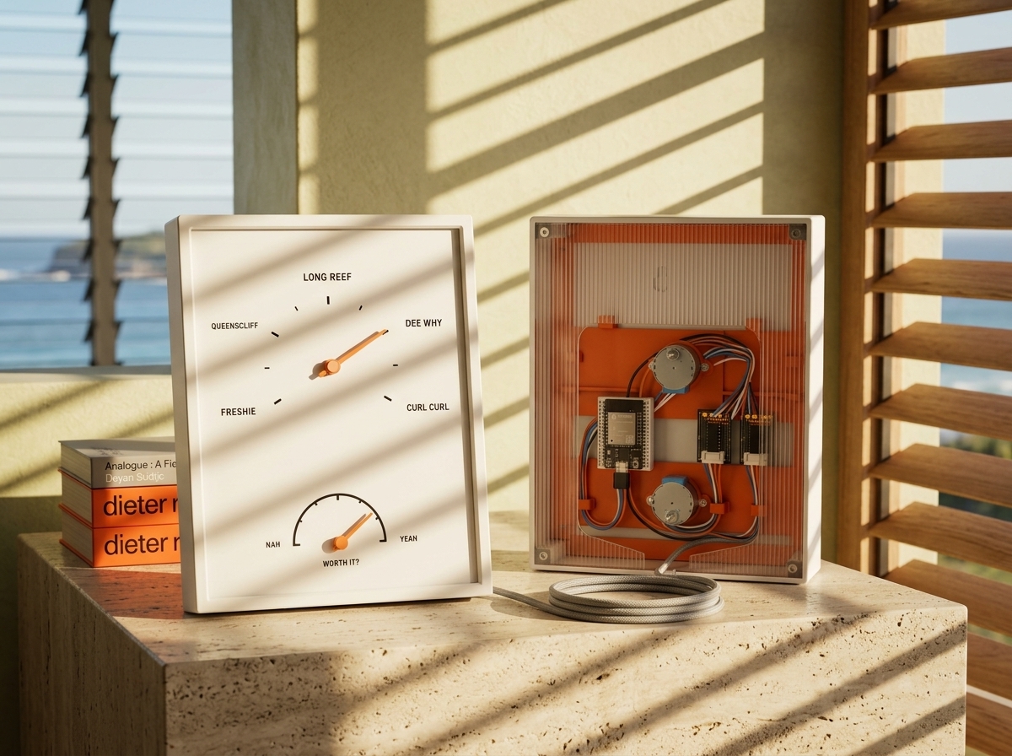
FINAL_PRINT_FILES/PHOTOGRAPHY_LOOKBOOK/11_Bondi_Penthouse_Travertine_Ribbed_Clear_Back_Duo.jpg
