brickrockler/surfclock/FINAL_PRINT_FILES/PHOTOGRAPHY_LOOKBOOK/11_Prusa_Fleet_3_Beds_Loaded_Render.jpg

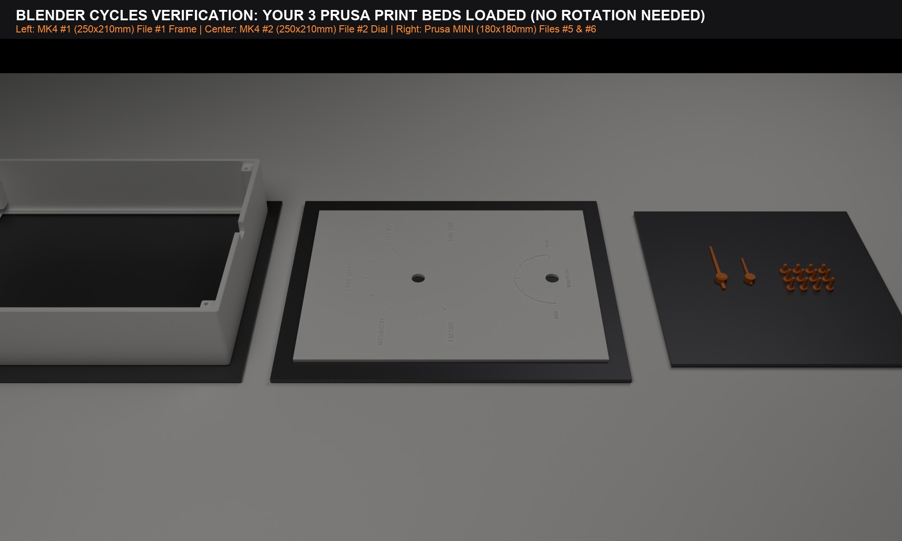
FINAL_PRINT_FILES/PHOTOGRAPHY_LOOKBOOK/11_Prusa_Fleet_3_Beds_Loaded_Render.jpg
