brickrockler/surfclock/FINAL_PRINT_FILES/PHOTOGRAPHY_LOOKBOOK/12_Macro_Ribbed_Clear_PLA_Exhibition_Back_and_Orange_Plate.jpg

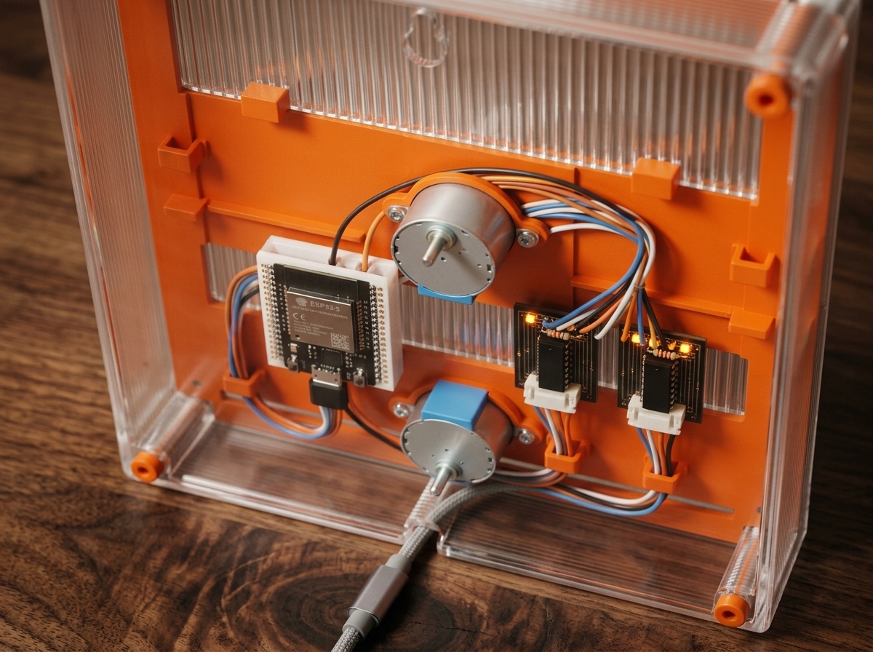
FINAL_PRINT_FILES/PHOTOGRAPHY_LOOKBOOK/12_Macro_Ribbed_Clear_PLA_Exhibition_Back_and_Orange_Plate.jpg
