brickrockler/surfclock/FINAL_PRINT_FILES/PHOTOGRAPHY_LOOKBOOK/14_Blender_Cycles_Full_Studio_Front_and_Rear_Duo.jpg

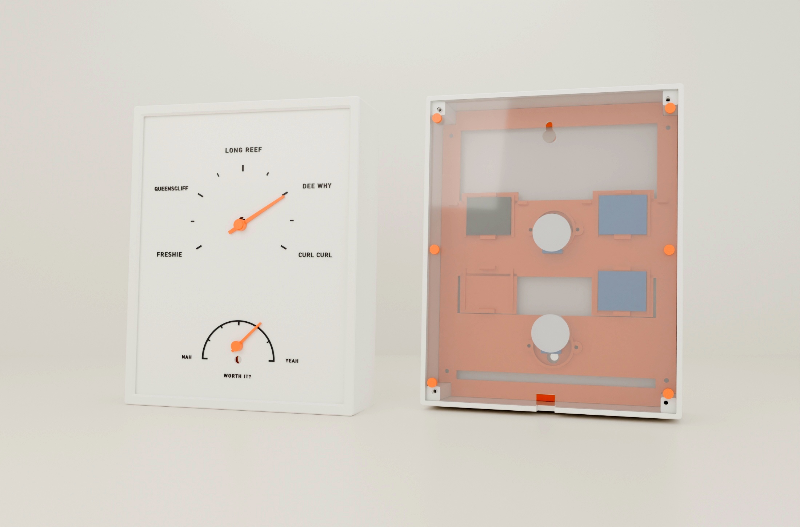
FINAL_PRINT_FILES/PHOTOGRAPHY_LOOKBOOK/14_Blender_Cycles_Full_Studio_Front_and_Rear_Duo.jpg
