brickrockler/surfclock/FINAL_PRINT_FILES/PHOTOGRAPHY_LOOKBOOK/15_Blender_Cycles_STL_New_SnapClip_Motor_Plate_Exhibition_Hero.jpg

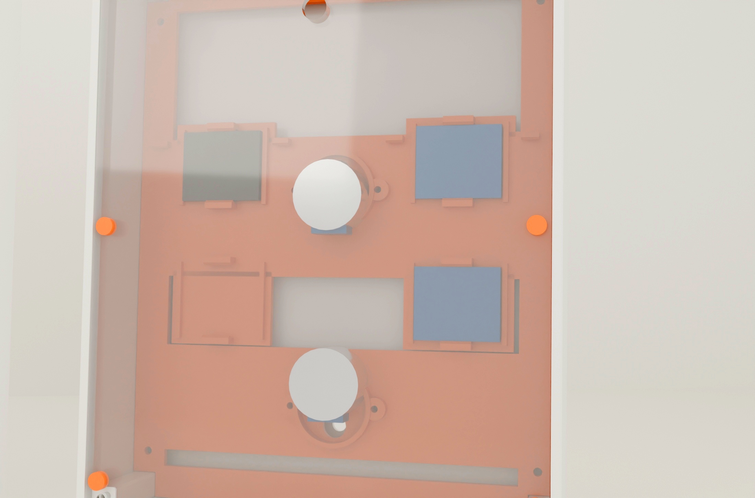
FINAL_PRINT_FILES/PHOTOGRAPHY_LOOKBOOK/15_Blender_Cycles_STL_New_SnapClip_Motor_Plate_Exhibition_Hero.jpg
