brickrockler/surfclock/FINAL_PRINT_FILES/PHOTOGRAPHY_LOOKBOOK/20_Photoreal_Studio_Masterpiece_v6.jpg

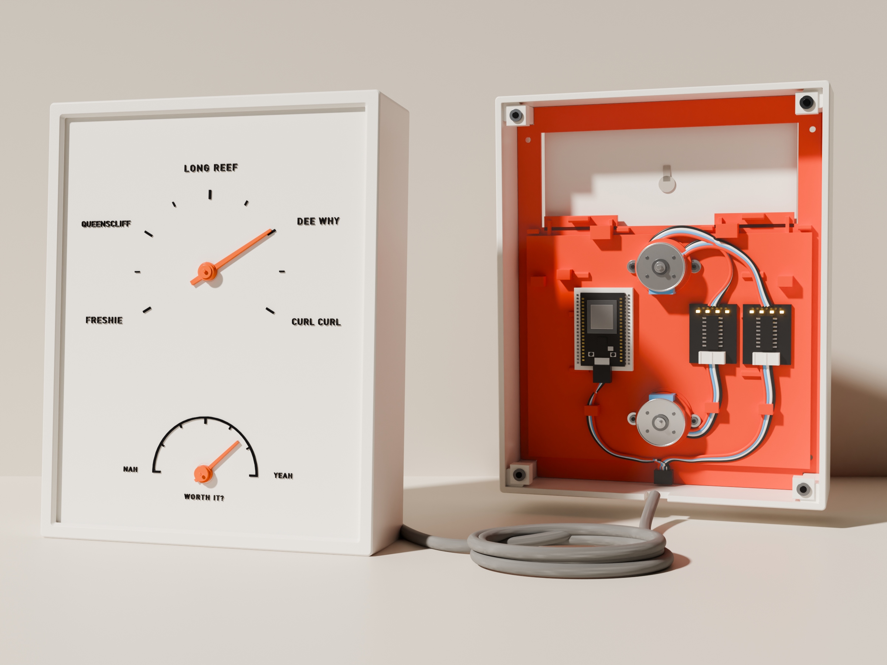
FINAL_PRINT_FILES/PHOTOGRAPHY_LOOKBOOK/20_Photoreal_Studio_Masterpiece_v6.jpg
