brickrockler/surfclock/FINAL_PRINT_FILES/PHOTOGRAPHY_LOOKBOOK/21_Photoreal_Studio_Masterpiece_v7.jpg

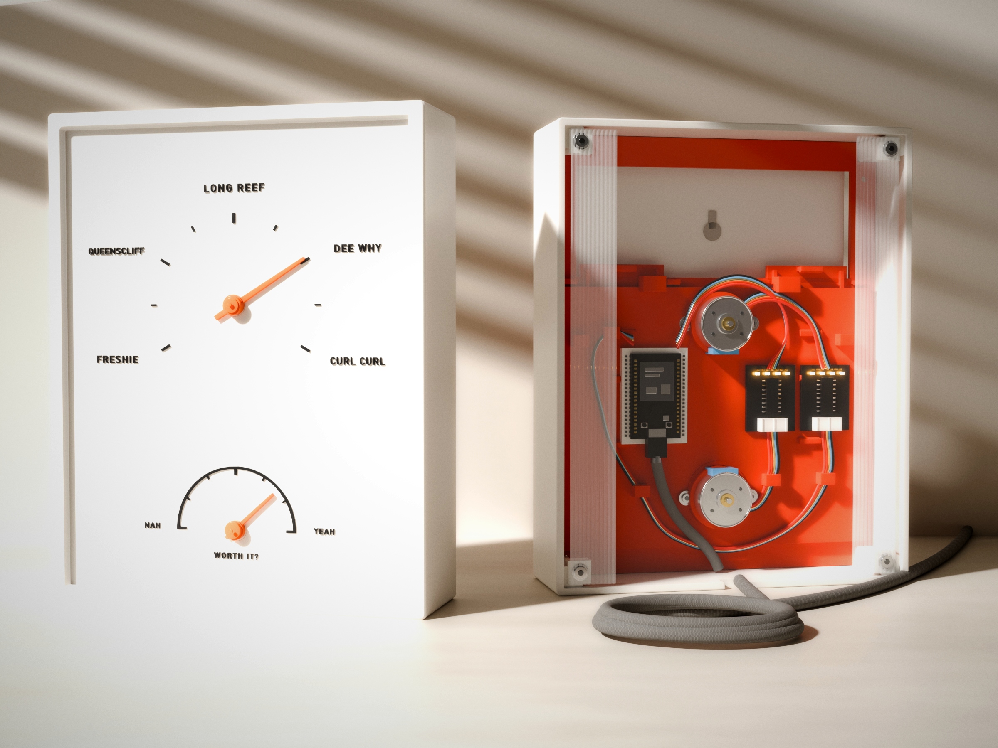
FINAL_PRINT_FILES/PHOTOGRAPHY_LOOKBOOK/21_Photoreal_Studio_Masterpiece_v7.jpg
