brickrockler/surfclock/FINAL_PRINT_FILES/PHOTOGRAPHY_LOOKBOOK/22_Photoreal_Studio_Masterpiece_v8.jpg

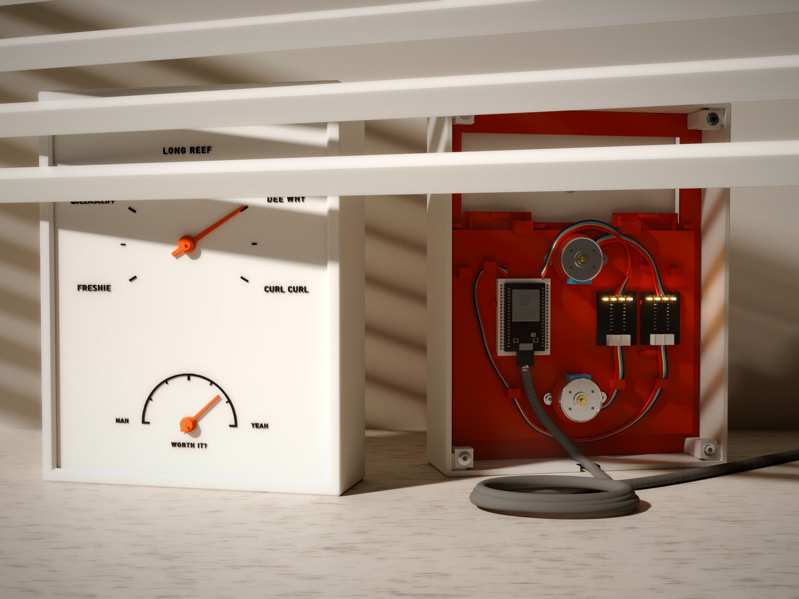
FINAL_PRINT_FILES/PHOTOGRAPHY_LOOKBOOK/22_Photoreal_Studio_Masterpiece_v8.jpg
