brickrockler/surfclock/FINAL_PRINT_FILES/PHOTOGRAPHY_LOOKBOOK/24_Photoreal_Studio_Masterpiece_v10_RAW.jpg

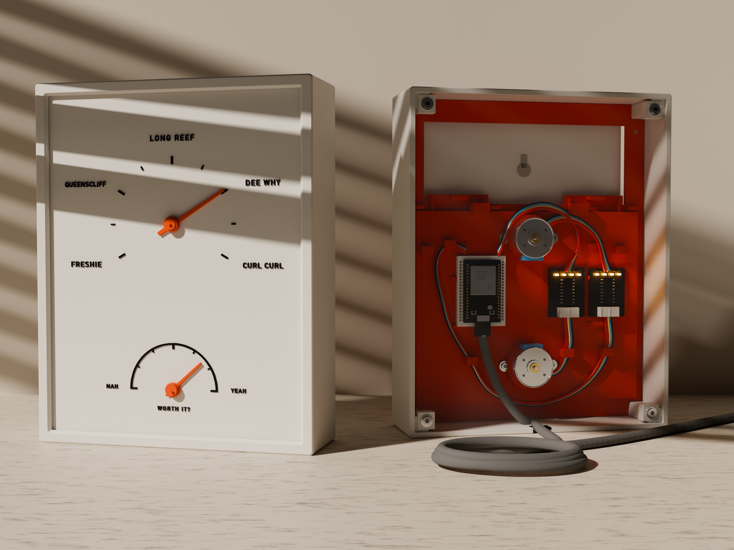
FINAL_PRINT_FILES/PHOTOGRAPHY_LOOKBOOK/24_Photoreal_Studio_Masterpiece_v10_RAW.jpg
