brickrockler/surfclock/FINAL_PRINT_FILES/PHOTOGRAPHY_LOOKBOOK/25_Photoreal_Studio_Masterpiece_v11.jpg

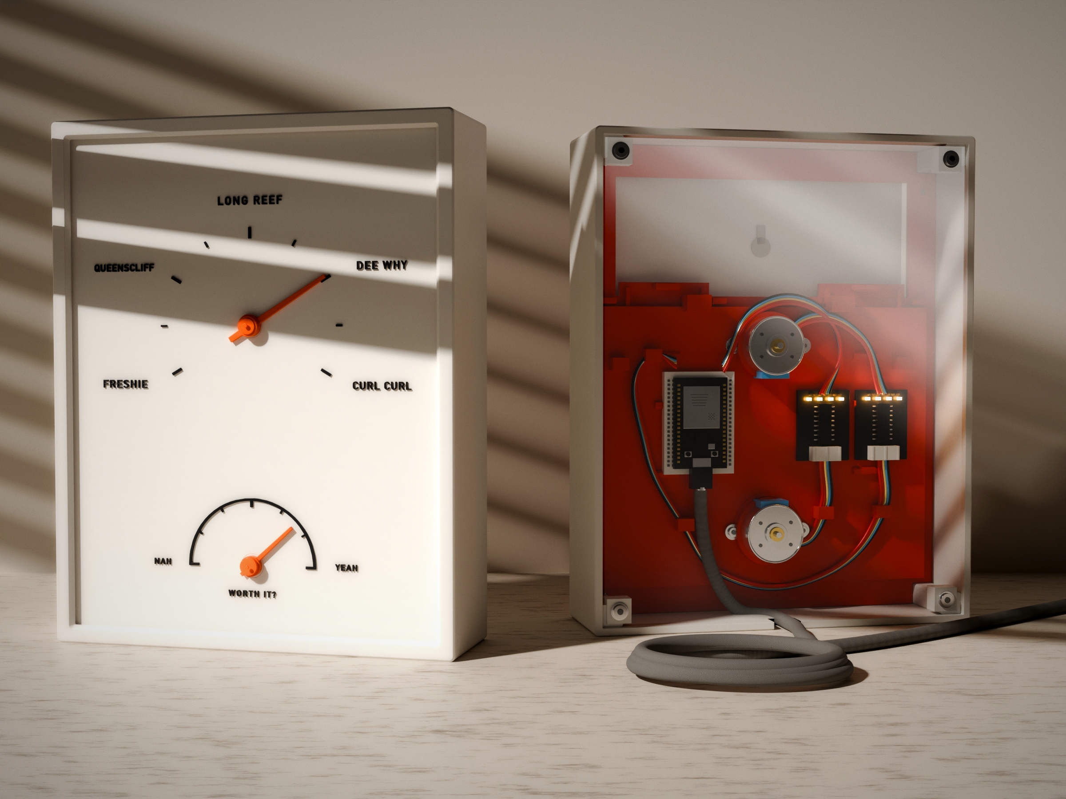
FINAL_PRINT_FILES/PHOTOGRAPHY_LOOKBOOK/25_Photoreal_Studio_Masterpiece_v11.jpg
