brickrockler/surfclock/FINAL_PRINT_FILES/PURE_BLENDER_CYCLES_LOOKBOOK/00_PURE_BLENDER_MASTER_CONTACT_SHEET.jpg

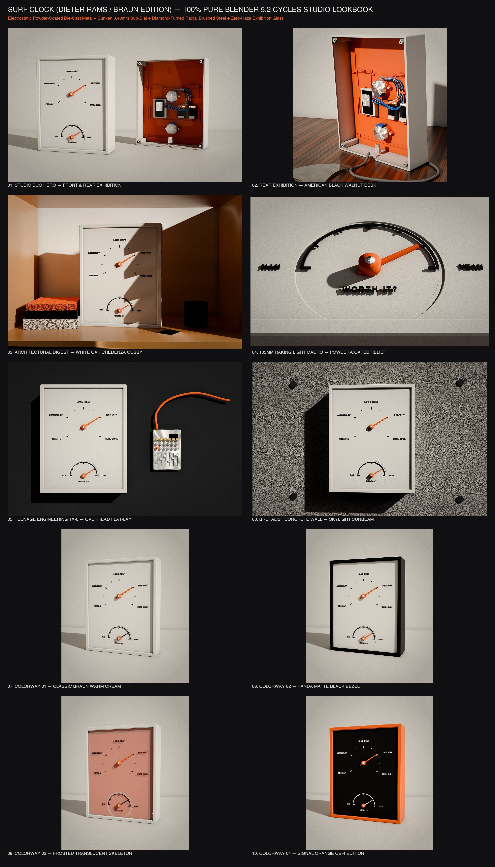
FINAL_PRINT_FILES/PURE_BLENDER_CYCLES_LOOKBOOK/00_PURE_BLENDER_MASTER_CONTACT_SHEET.jpg
