brickrockler/surfclock/FINAL_PRINT_FILES/PURE_BLENDER_CYCLES_LOOKBOOK/01_studio_duo_hero.jpg

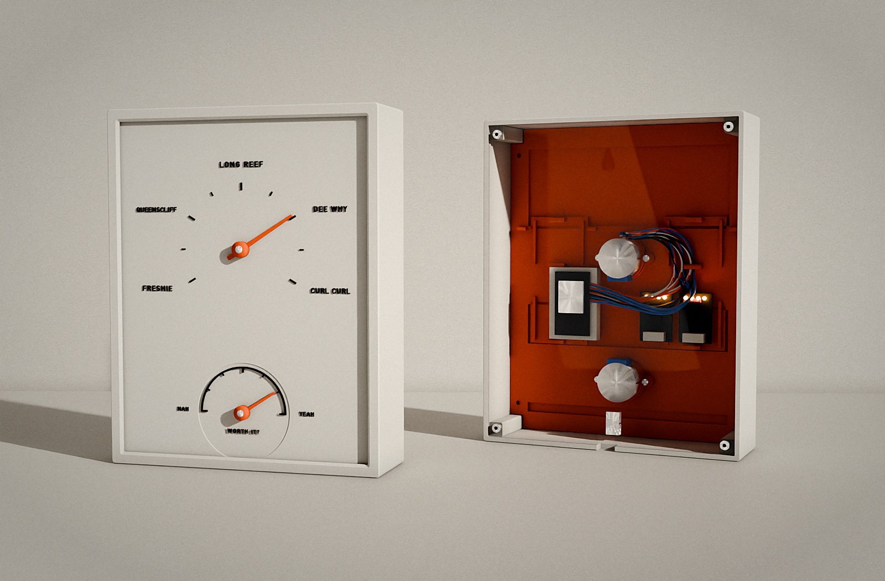
FINAL_PRINT_FILES/PURE_BLENDER_CYCLES_LOOKBOOK/01_studio_duo_hero.jpg
