brickrockler/surfclock/FINAL_PRINT_FILES/PURE_BLENDER_CYCLES_LOOKBOOK/02_rear_exhibition_walnut_desk.jpg

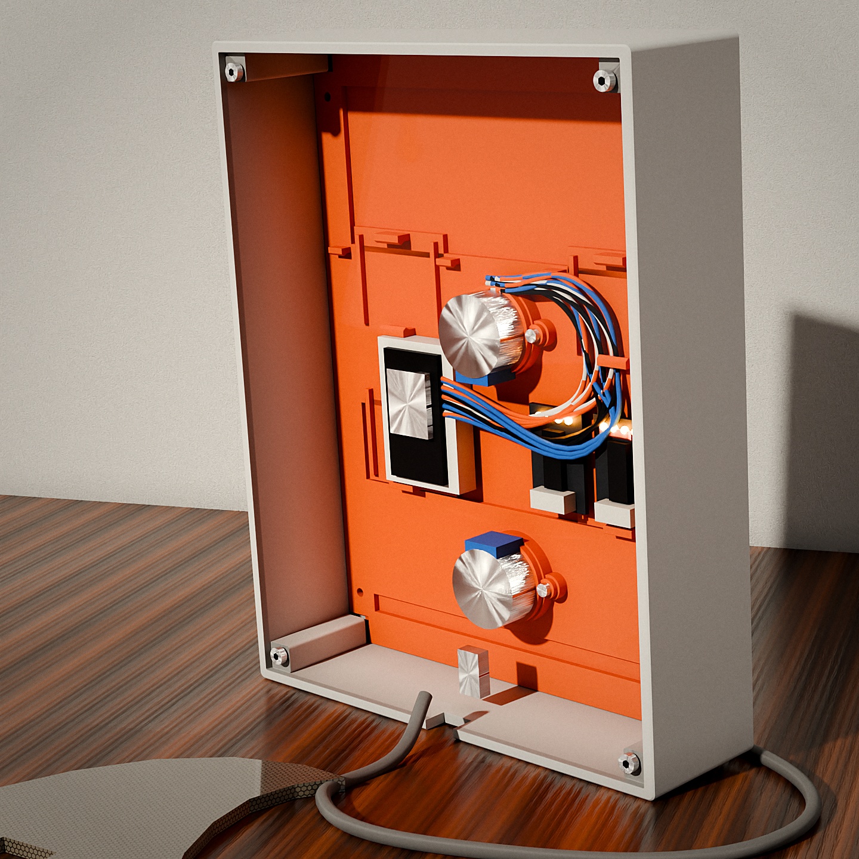
FINAL_PRINT_FILES/PURE_BLENDER_CYCLES_LOOKBOOK/02_rear_exhibition_walnut_desk.jpg
