brickrockler/surfclock/FINAL_PRINT_FILES/PURE_BLENDER_CYCLES_LOOKBOOK/03_architectural_digest_oak_credenza.jpg

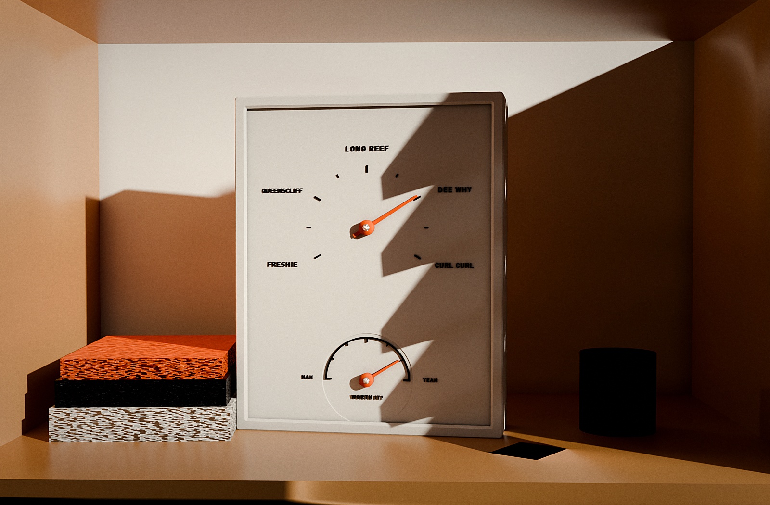
FINAL_PRINT_FILES/PURE_BLENDER_CYCLES_LOOKBOOK/03_architectural_digest_oak_credenza.jpg
