brickrockler/surfclock/V5_PERFECT_CLICKLOCK_PRINT_KIT/0_FIXED_CORNERS_AND_30DEG_RAMPS_PROOF.png

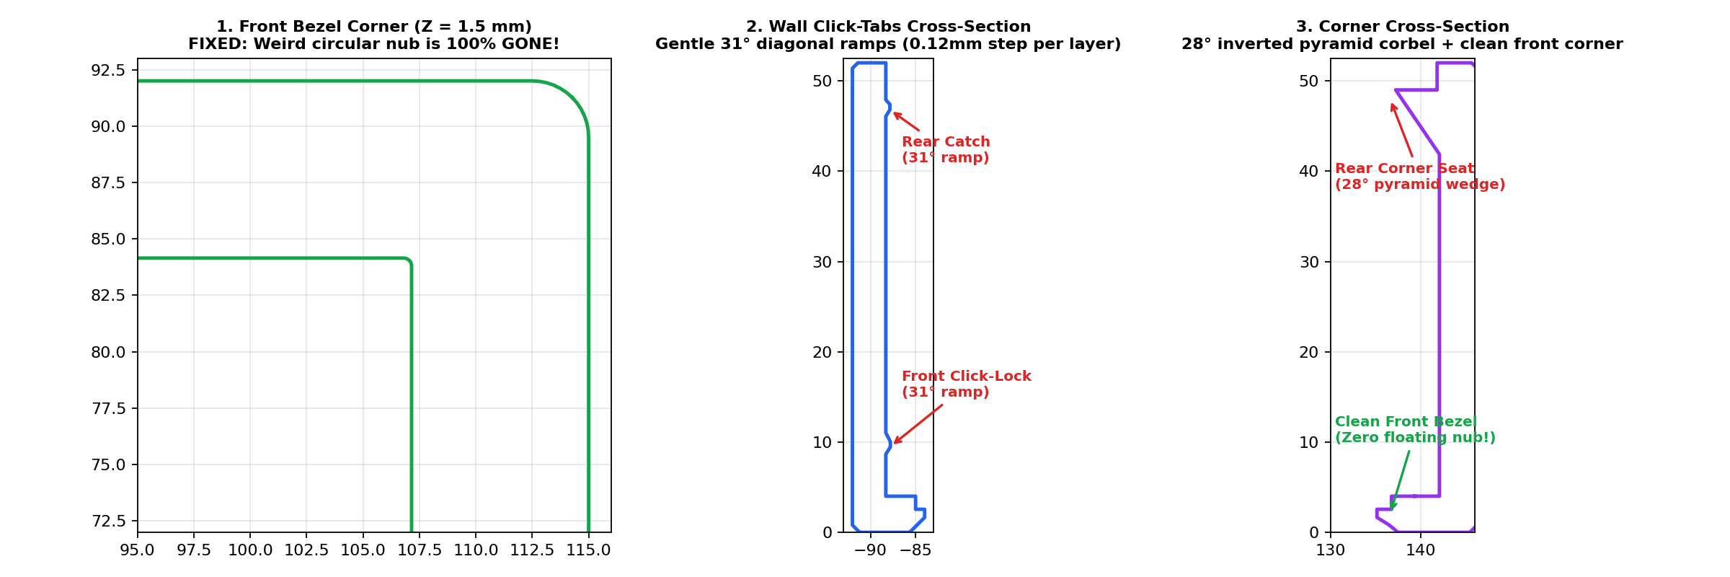
V5_PERFECT_CLICKLOCK_PRINT_KIT/0_FIXED_CORNERS_AND_30DEG_RAMPS_PROOF.png
