brickrockler/surfclock/V5_PERFECT_CLICKLOCK_PRINT_KIT/0_HIDDEN_REAR_SNAP_CLIP_DIAGRAM.png

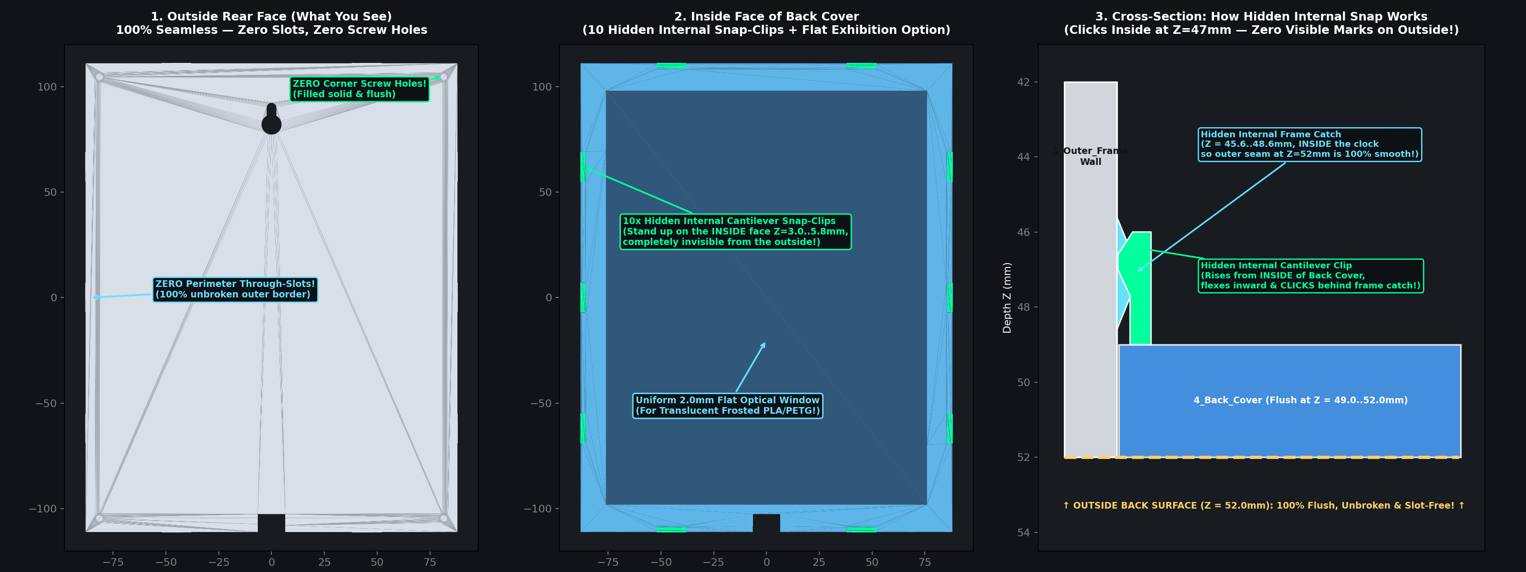
V5_PERFECT_CLICKLOCK_PRINT_KIT/0_HIDDEN_REAR_SNAP_CLIP_DIAGRAM.png
