brickrockler/surfclock/V5_PERFECT_CLICKLOCK_PRINT_KIT/0_LOW_PROFILE_ESP32_CRADLE_PROOF.png

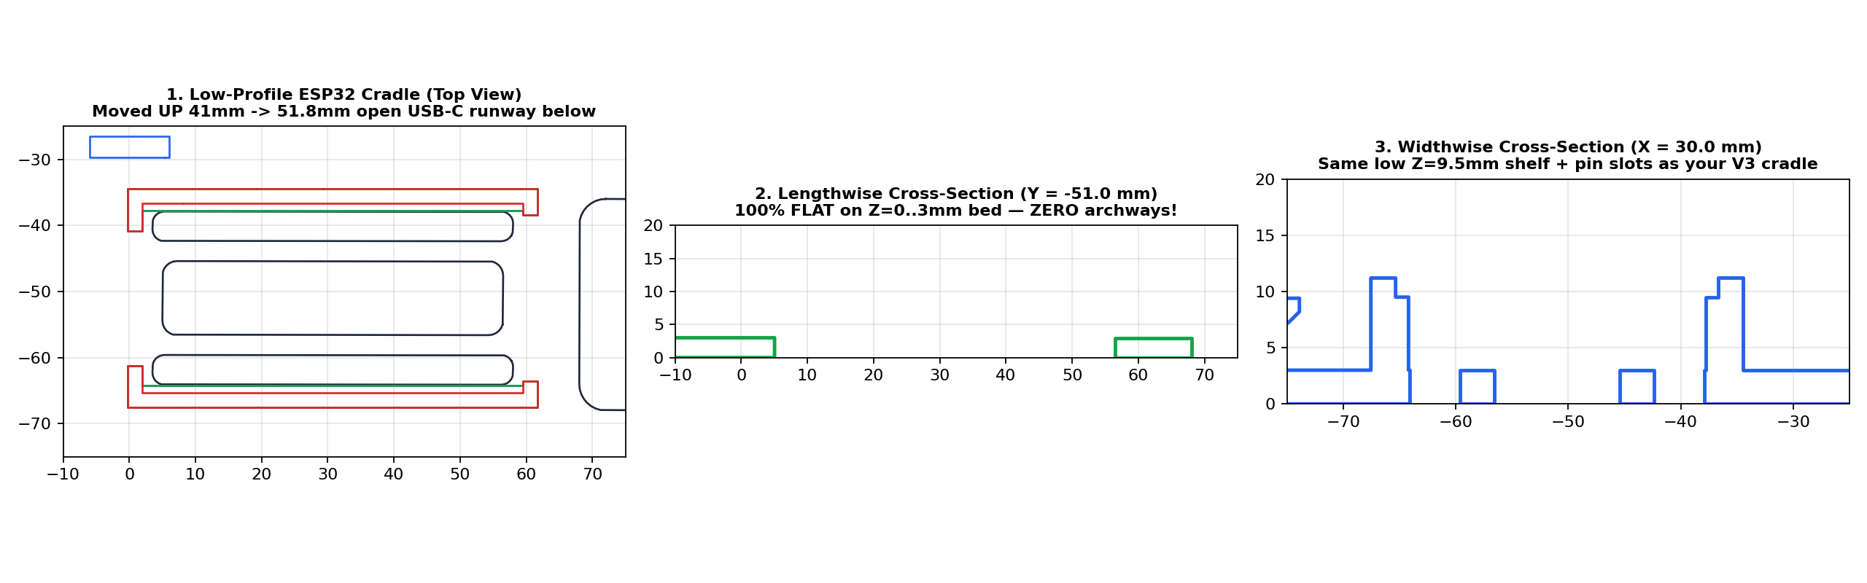
V5_PERFECT_CLICKLOCK_PRINT_KIT/0_LOW_PROFILE_ESP32_CRADLE_PROOF.png
