brickrockler/surfclock/V5_PERFECT_CLICKLOCK_PRINT_KIT/diagrams_and_renders/motor_plate_layer1_fixed.png

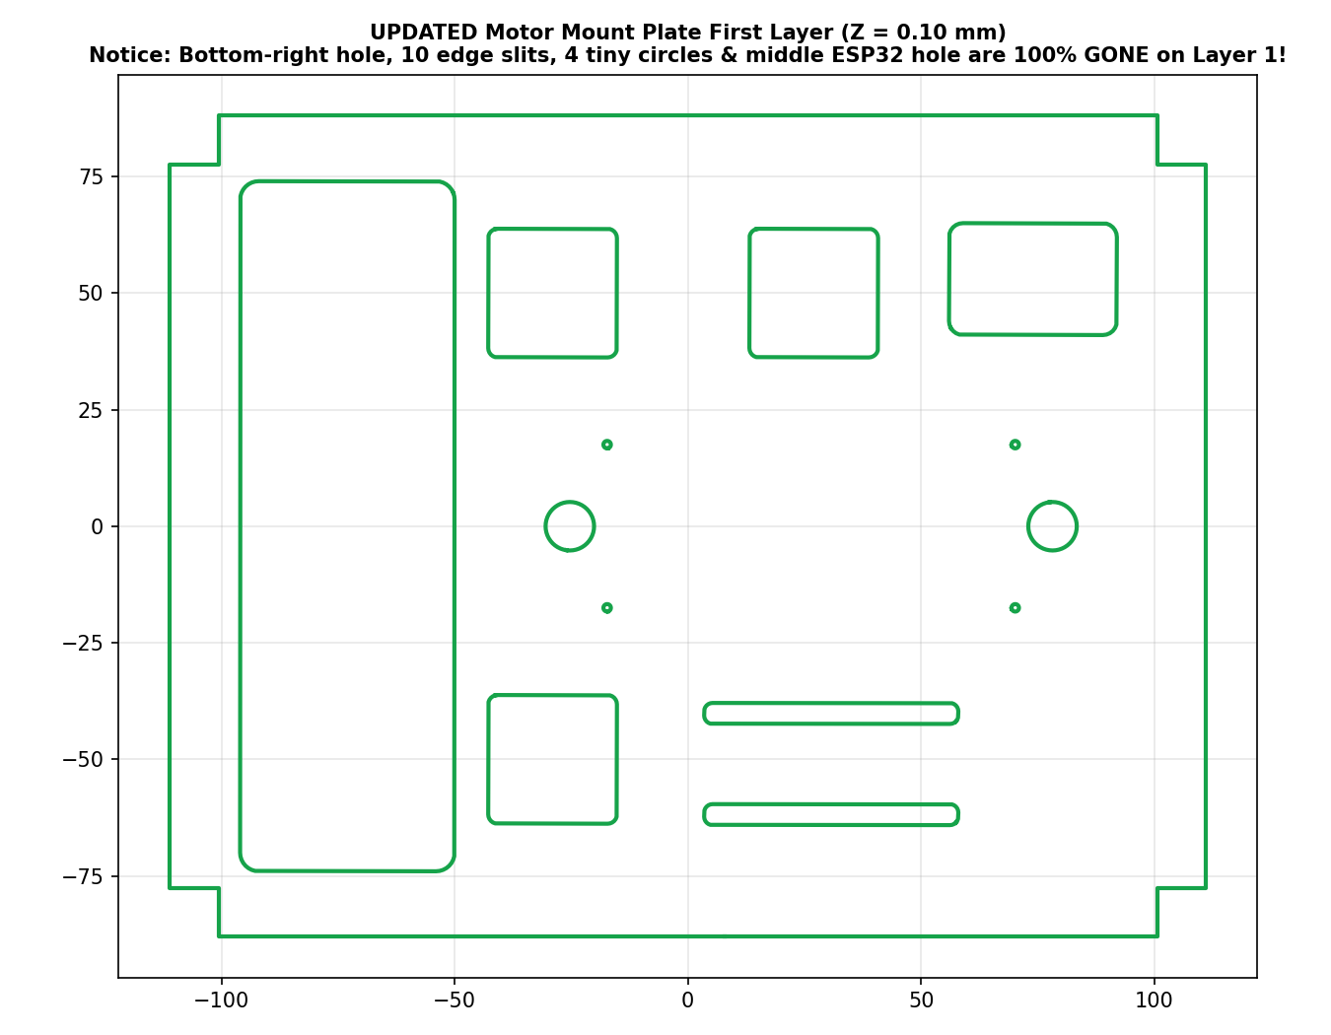
V5_PERFECT_CLICKLOCK_PRINT_KIT/diagrams_and_renders/motor_plate_layer1_fixed.png
