brickrockler/surfclock/V5_PERFECT_CLICKLOCK_PRINT_KIT/diagrams_and_renders/motor_plate_unbroken_layer1_proof.png

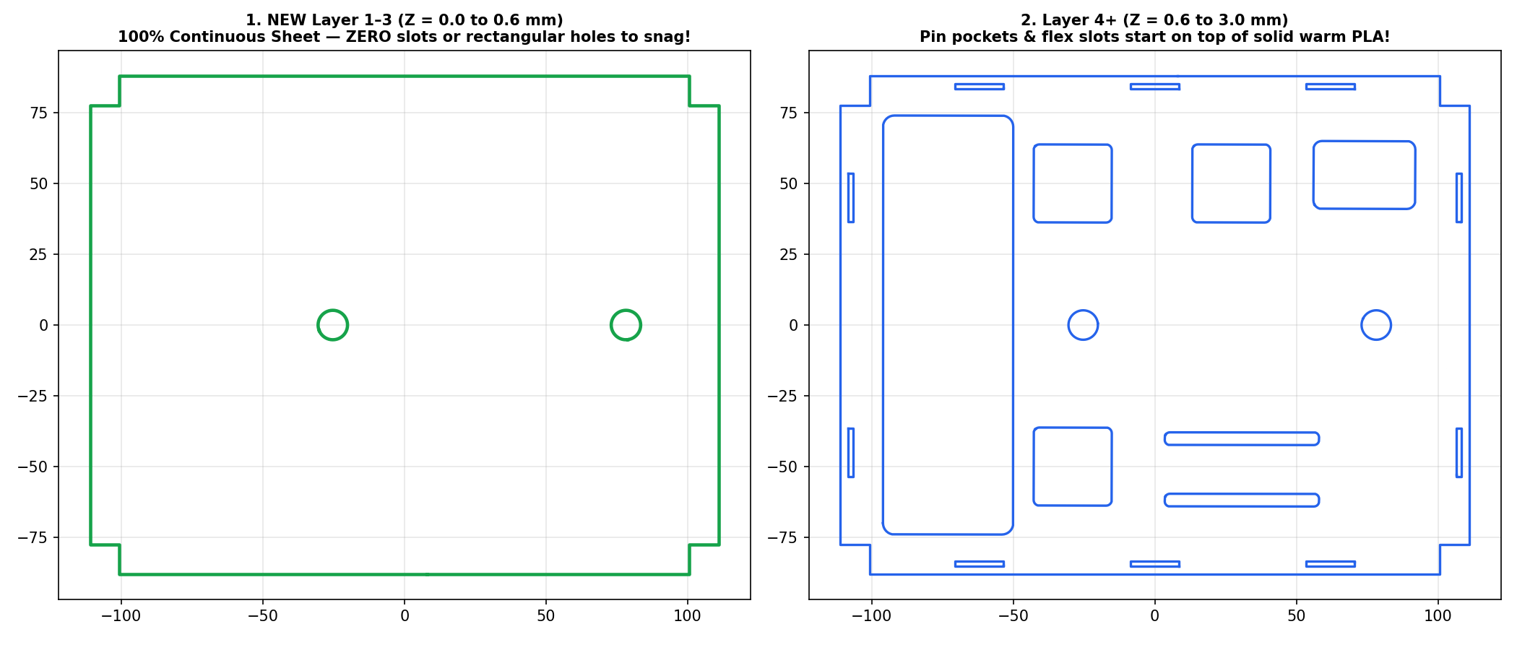
V5_PERFECT_CLICKLOCK_PRINT_KIT/diagrams_and_renders/motor_plate_unbroken_layer1_proof.png
