brickrockler/surfclock/V5_PERFECT_CLICKLOCK_PRINT_KIT/diagrams_and_renders/render_te_all_cool_light_grey_monolith_translucent_back.jpg

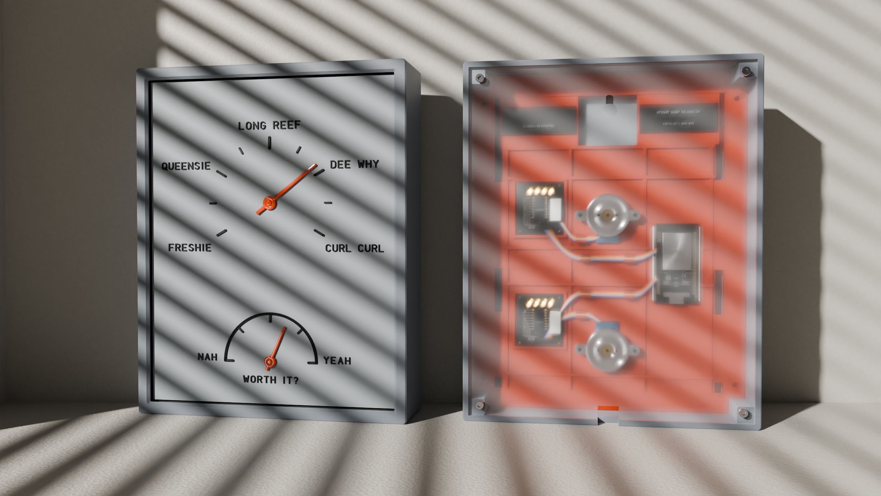
V5_PERFECT_CLICKLOCK_PRINT_KIT/diagrams_and_renders/render_te_all_cool_light_grey_monolith_translucent_back.jpg
