brickrockler/surfclock/V5_PERFECT_CLICKLOCK_PRINT_KIT/diagrams_and_renders/v6_bulletproof_motor_plate_audit.png

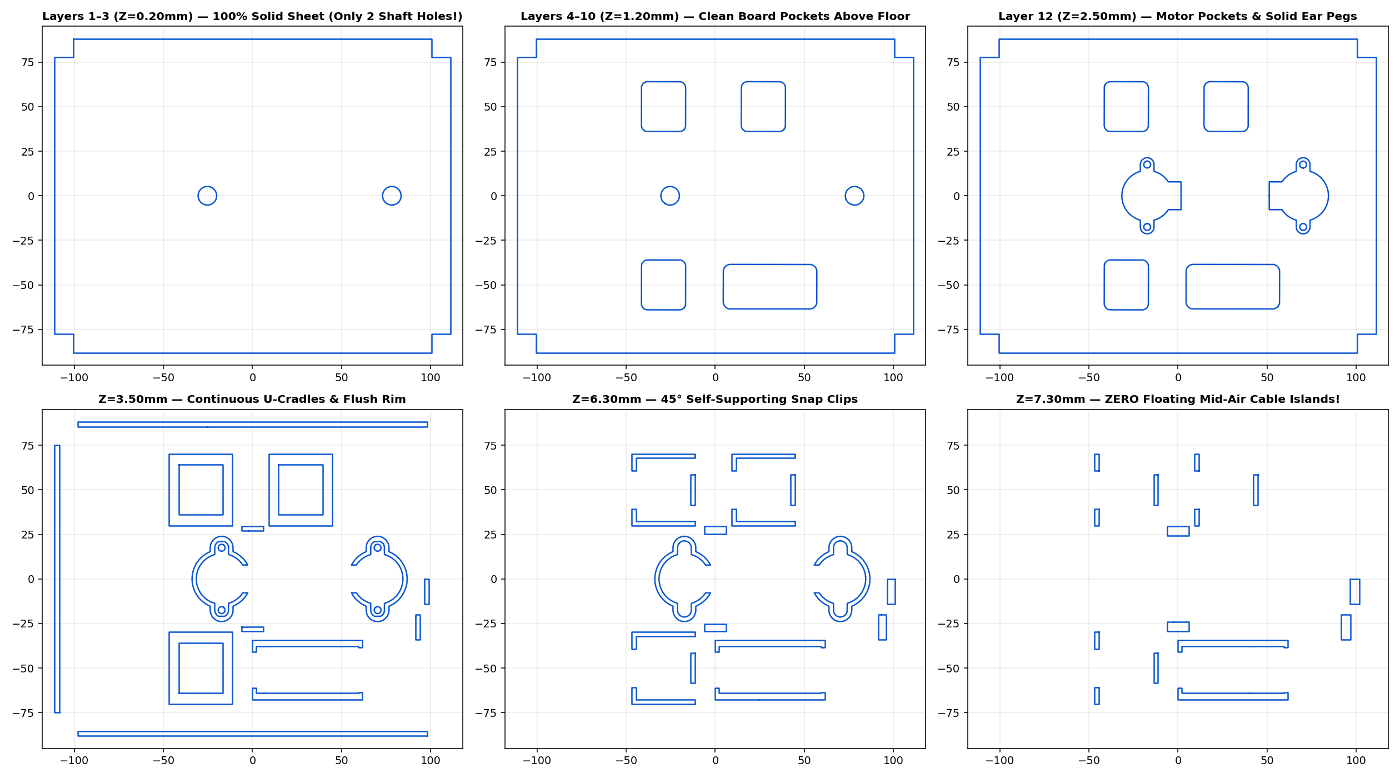
V5_PERFECT_CLICKLOCK_PRINT_KIT/diagrams_and_renders/v6_bulletproof_motor_plate_audit.png
