brickrockler/surfclock/V5_PERFECT_CLICKLOCK_PRINT_KIT/diagrams_and_renders/v7_corner_fit_inside_frame_proof.png

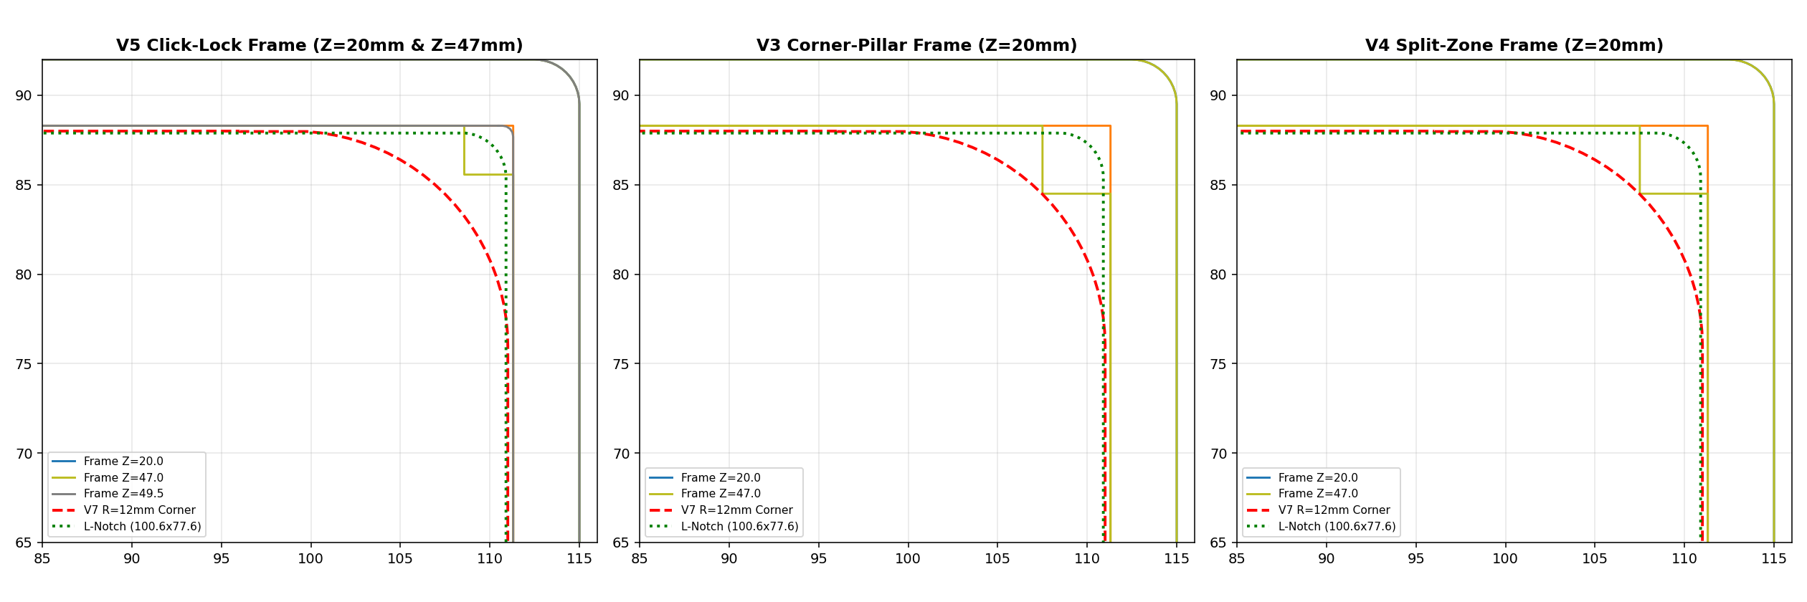
V5_PERFECT_CLICKLOCK_PRINT_KIT/diagrams_and_renders/v7_corner_fit_inside_frame_proof.png
