brickrockler/surfclock/V5_PERFECT_CLICKLOCK_PRINT_KIT/diagrams_and_renders/v7_pure_rect_layer1_proof.png

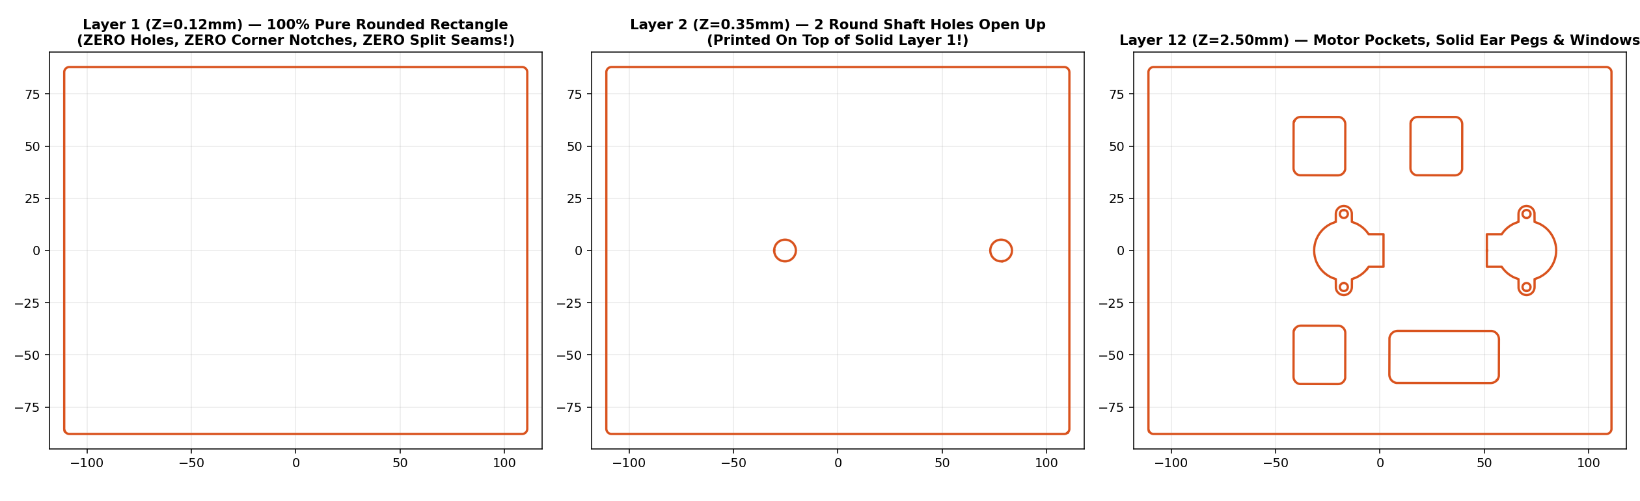
V5_PERFECT_CLICKLOCK_PRINT_KIT/diagrams_and_renders/v7_pure_rect_layer1_proof.png
