brickrockler/surfclock/V5_PERFECT_CLICKLOCK_PRINT_KIT/diagrams_and_renders/v9_open_skeleton_vs_v7_slab.png

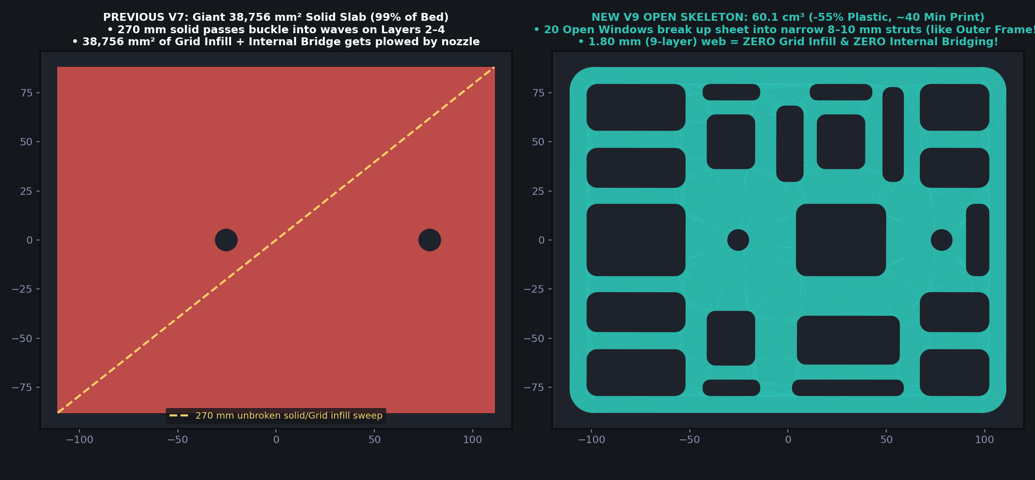
V5_PERFECT_CLICKLOCK_PRINT_KIT/diagrams_and_renders/v9_open_skeleton_vs_v7_slab.png
