brickrockler/surfclock/V5_PERFECT_CLICKLOCK_PRINT_KIT/diagrams_and_renders/v10_forensic_slicer_audit.png

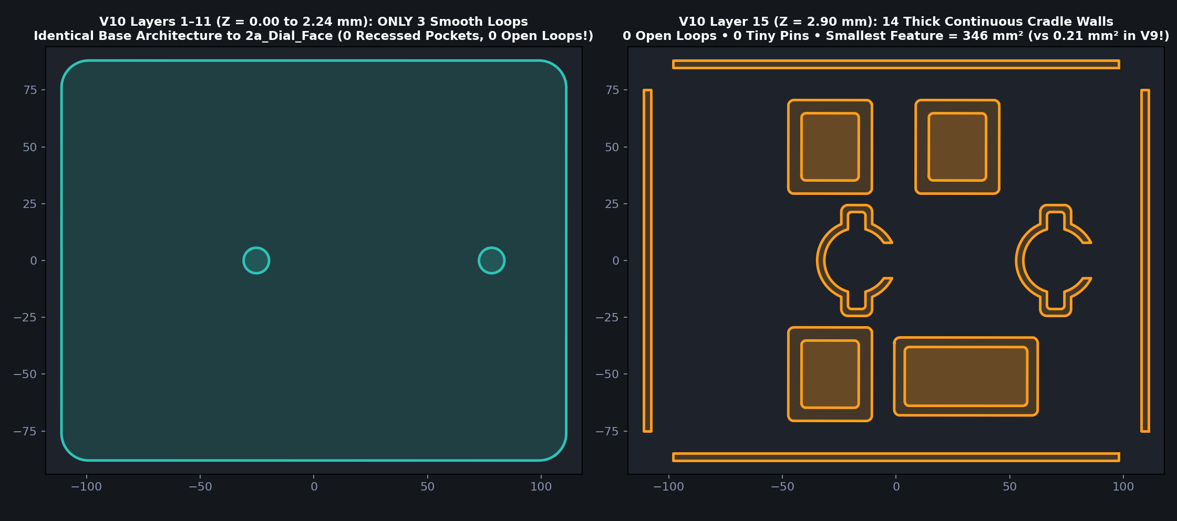
V5_PERFECT_CLICKLOCK_PRINT_KIT/diagrams_and_renders/v10_forensic_slicer_audit.png
