brickrockler/surfclock/FINAL_PRINT_FILES/PHOTOGRAPHY_LOOKBOOK/13_True_Blender_Cycles_STL_Verified_Front_and_Rear_Duo.jpg

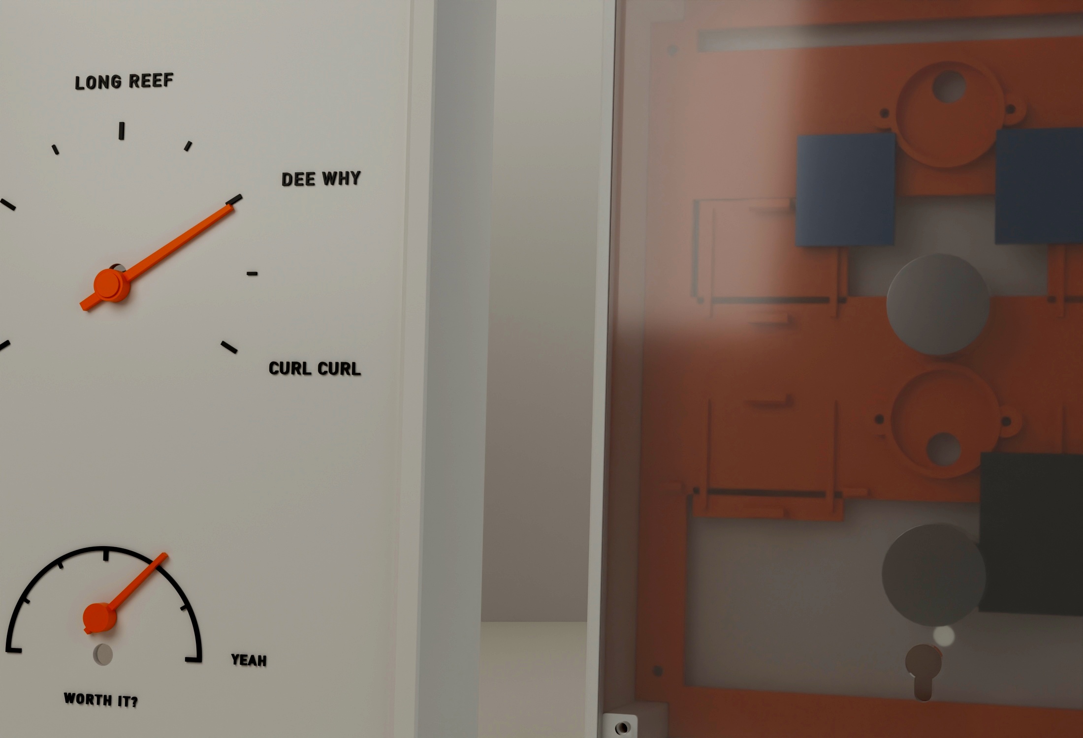
FINAL_PRINT_FILES/PHOTOGRAPHY_LOOKBOOK/13_True_Blender_Cycles_STL_Verified_Front_and_Rear_Duo.jpg
