brickrockler/surfclock/FINAL_PRINT_FILES/PHOTOGRAPHY_LOOKBOOK/16_Gauntlet_Verified_Masterpiece_Front_and_Rear_Duo.jpg

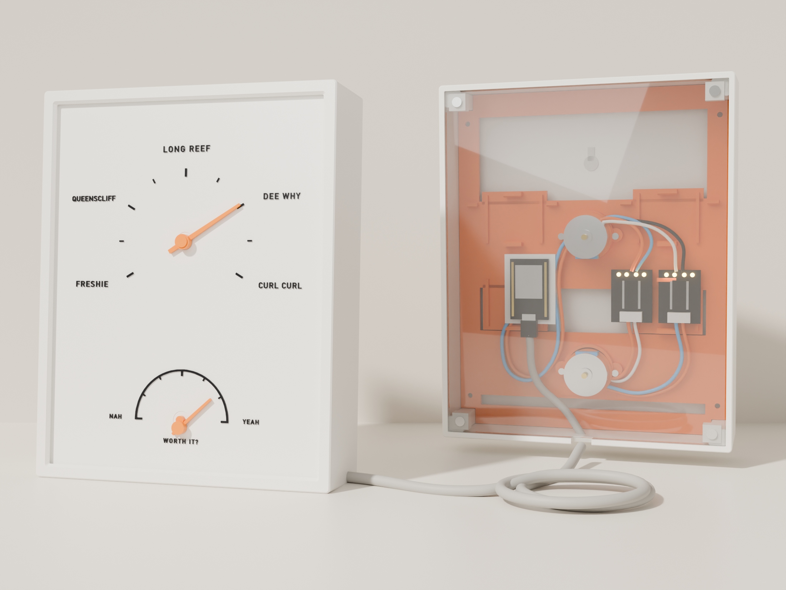
FINAL_PRINT_FILES/PHOTOGRAPHY_LOOKBOOK/16_Gauntlet_Verified_Masterpiece_Front_and_Rear_Duo.jpg
