brickrockler/surfclock/FINAL_PRINT_FILES/PHOTOGRAPHY_LOOKBOOK/17_Gauntlet_Verified_Masterpiece_v3.jpg

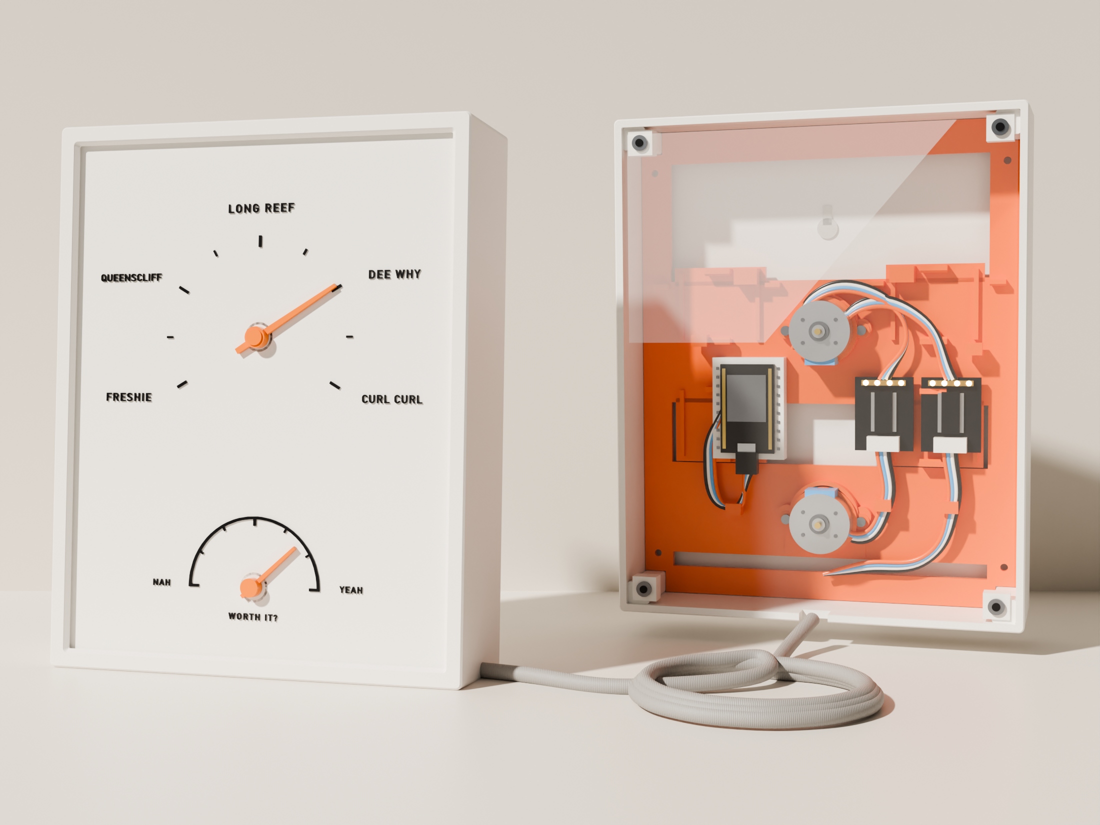
FINAL_PRINT_FILES/PHOTOGRAPHY_LOOKBOOK/17_Gauntlet_Verified_Masterpiece_v3.jpg
