brickrockler/surfclock/FINAL_PRINT_FILES/PHOTOGRAPHY_LOOKBOOK/18_Gauntlet_Verified_Masterpiece_v4.jpg

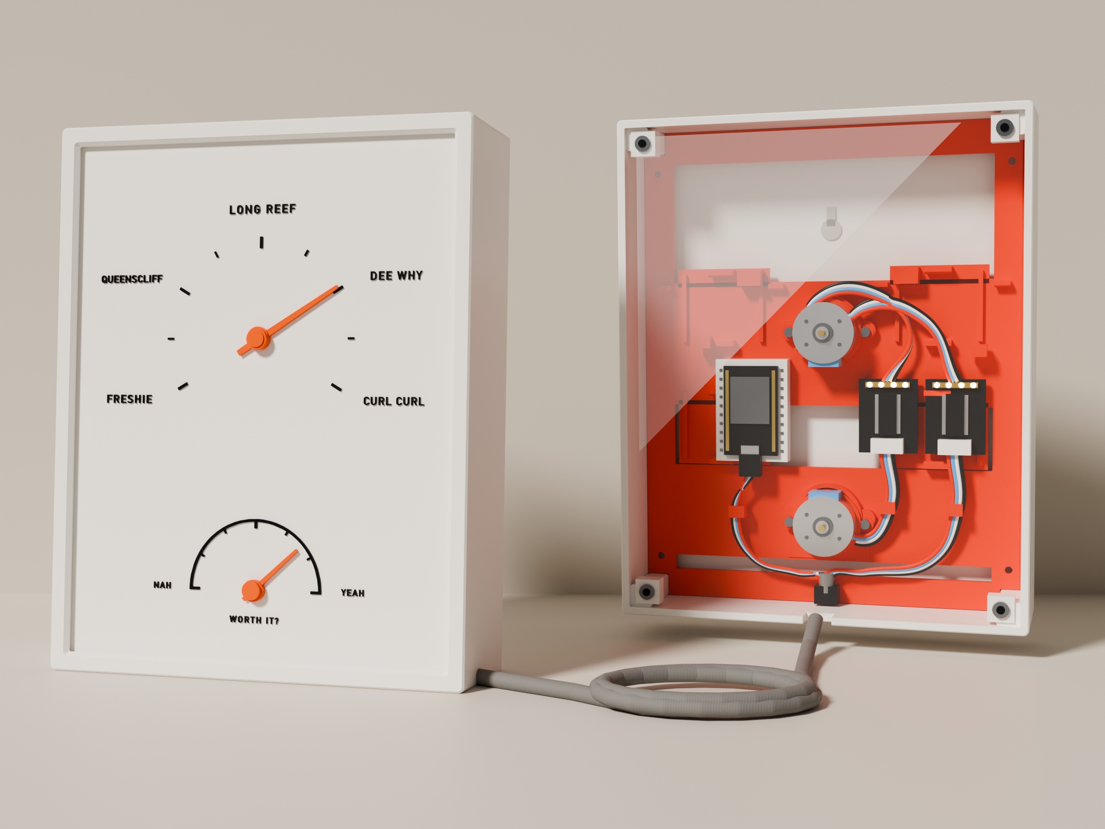
FINAL_PRINT_FILES/PHOTOGRAPHY_LOOKBOOK/18_Gauntlet_Verified_Masterpiece_v4.jpg
