brickrockler/surfclock/V5_PERFECT_CLICKLOCK_PRINT_KIT/scripts/generate_zero_vulnerability_dials.py

import sys
sys.path.insert(0, "/Users/jcolley/surf_clock")
import trimesh
import build_v3_dial_faces_fast as bdf

# Load the 100% manifold base plate from /tmp/clean_base_plate.stl
m_base = trimesh.load("/tmp/clean_base_plate.stl")
print("Loaded base plate -> is_watertight:", m_base.is_watertight, "faces:", len(m_base.faces))
base_tris = [tuple(map(tuple, tri)) for tri in m_base.triangles]
bdf.make_clean_chamfered_dial_plate_tris = lambda *a, **kw: list(base_tris)

# Give each stroke a microscopic unique offset (0.00013 * idx mm) so two strokes sharing an endpoint
# NEVER emit duplicate triangles or coplanar faces!
orig_stroke = bdf.make_stepped_stadium_stroke_bed
stroke_counter = [0]

def unique_watertight_stroke(xp0, yp0, xp1, yp1, width, z_root=2.30, z_ped=2.58, z_top=3.16, flare_extra=0.28, cap_segs=10):
    stroke_counter[0] += 1
    k = stroke_counter[0]
    # Microscopic prime-Desk offsets (< 0.002 mm = 2 microns, 100x smaller than layer height!)
    # Guarantees ZERO duplicate vertices/triangles between adjacent strokes!
    eps_w = 0.00011 * (k % 19)
    eps_z = 0.00007 * (k % 23)
    return orig_stroke(
        xp0 + 0.00003 * (k % 11),
        yp0 + 0.00003 * (k % 13),
        xp1 - 0.00003 * (k % 17),
        yp1 - 0.00003 * (k % 7),
        width + eps_w,
        z_root=2.30 - eps_z,
        z_ped=2.58 + eps_z * 0.5,
        z_top=3.16,
        flare_extra=flare_extra + eps_w * 0.5,
        cap_segs=cap_segs
    )

bdf.make_stepped_stadium_stroke_bed = unique_watertight_stroke

orig_arc = bdf.make_stepped_arc_extrusion_portrait
bdf.make_stepped_arc_extrusion_portrait = lambda cx_p, cy_p, r_in, r_out, deg_start, deg_end, **kw: orig_arc(
    cx_p, cy_p, r_in, r_out, deg_start, deg_end, z_root=2.32, z_ped=2.58, z_top=3.16, flare_side=0.14, segs=72
)

# Generate all 3 dial faces
bdf.build_custom_dial_stl(
    ["LONG REEF", "QUEENSIE", "DEE WHY", "FRESHIE", "CURL CURL"],
    [
        "/Users/jcolley/surf_clock/V5_PERFECT_CLICKLOCK_PRINT_KIT/2a_Dial_Face_NORTHERN_BEACHES_Queensie_M600_at_Z2.6mm_PrusaMK4.stl",
        "/Users/jcolley/surf_clock/FINAL_PRINT_FILES/2_Dial_Face_WHITE_then_BLACK_at_Z2.6mm_PrusaMK4.stl",
        "/Users/jcolley/surf_clock/2_Dial_Face_WHITE_then_BLACK_at_Z2.6mm_PrusaMK4.stl",
    ],
    label="2a Northern Beaches (Queensie)"
)
bdf.build_custom_dial_stl(
    ["BONDI", "MANLY", "BRONTE", "TAMARAMA", "MAROUBRA"],
    [
        "/Users/jcolley/surf_clock/V5_PERFECT_CLICKLOCK_PRINT_KIT/2b_Dial_Face_SYDNEY_ICONS_Bondi_Bronte_M600_at_Z2.6mm_PrusaMK4.stl",
        "/Users/jcolley/surf_clock/FINAL_PRINT_FILES/2_Dial_Face_V3_SYDNEY_ICONS_Bondi_Bronte_PrusaMK4.stl",
        "/Users/jcolley/surf_clock/2_Dial_Face_V3_SYDNEY_ICONS_Bondi_Bronte_PrusaMK4.stl",
    ],
    label="2b Sydney Icons"
)
bdf.build_custom_dial_stl(
    ["BONDI", "TAMARAMA", "BRONTE", "COOGEE", "MAROUBRA"],
    [
        "/Users/jcolley/surf_clock/V5_PERFECT_CLICKLOCK_PRINT_KIT/2c_Dial_Face_EASTERN_SUBURBS_Bondi_Coogee_M600_at_Z2.6mm_PrusaMK4.stl",
        "/Users/jcolley/surf_clock/FINAL_PRINT_FILES/2_Dial_Face_V3_EASTERN_SUBURBS_Bondi_Bronte_Coogee_PrusaMK4.stl",
        "/Users/jcolley/surf_clock/2_Dial_Face_V3_EASTERN_SUBURBS_Bondi_Bronte_Coogee_PrusaMK4.stl",
    ],
    label="2c Eastern Suburbs"
)
