brickrockler/surfclock/(commit log)

2026-10-15 feat: add V5 click-lock print kit, studio 4K cinema pipeline, and web customizer updates
    [02_dial_faceplate_base.stl, 02a_dial_faceplate_with_text.stl, 02b_dial_text_and_arc_only.stl, 03_beach_hand_28byj48_capped.stl, 04_conditions_hand_28byj48_capped.stl, 05_rear_cover_usb.stl, 1_Outer_Frame_ClickLock_PrusaMK4.stl, 1b_OPTIONAL_Outer_Frame_SLIM_36mm_FastPrint_PrusaMK4.stl]
2026-10-15 feat(3d): add all STL, Blender, GLB, USD, and C4D 3D files
    [01_outer_bezel_chassis.stl, 02a_dial_faceplate_with_text.stl, 02b_dial_text_and_arc_only.stl, 03_beach_hand_28byj48_capped.stl, 04_conditions_hand_28byj48_capped.stl, 05_rear_cover_usb.stl, 06_dual_stepper_carrier_plate.stl, 0_FIX_TODAY_Wide_Hub_Hands_Plus_Spindle_Rings_PrusaMINI.stl]
